kholia/HF-Pre-Amp/README.md

Reference: https://www.qsl.net/py2ohh/trx/buffer/buffer.html

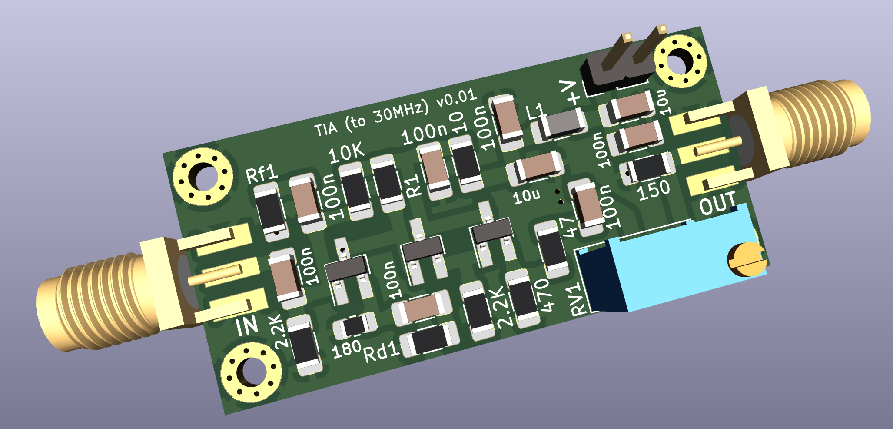
[picture p1: v5/Screenshot_2023-09-03_21-09-13.png]
Render


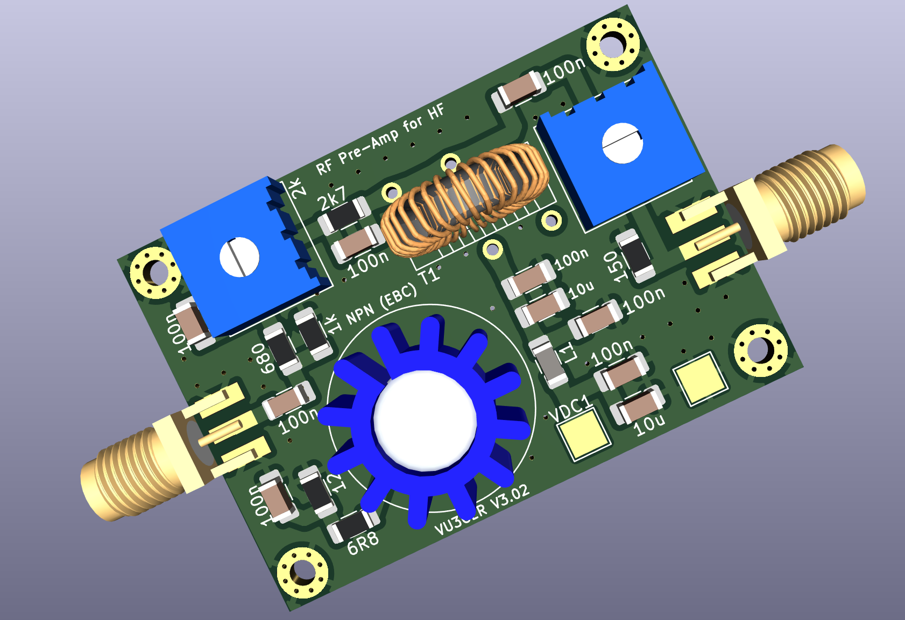
[picture p2: v3/Screenshot_2023-09-11_07-42-22.png]
Render 2


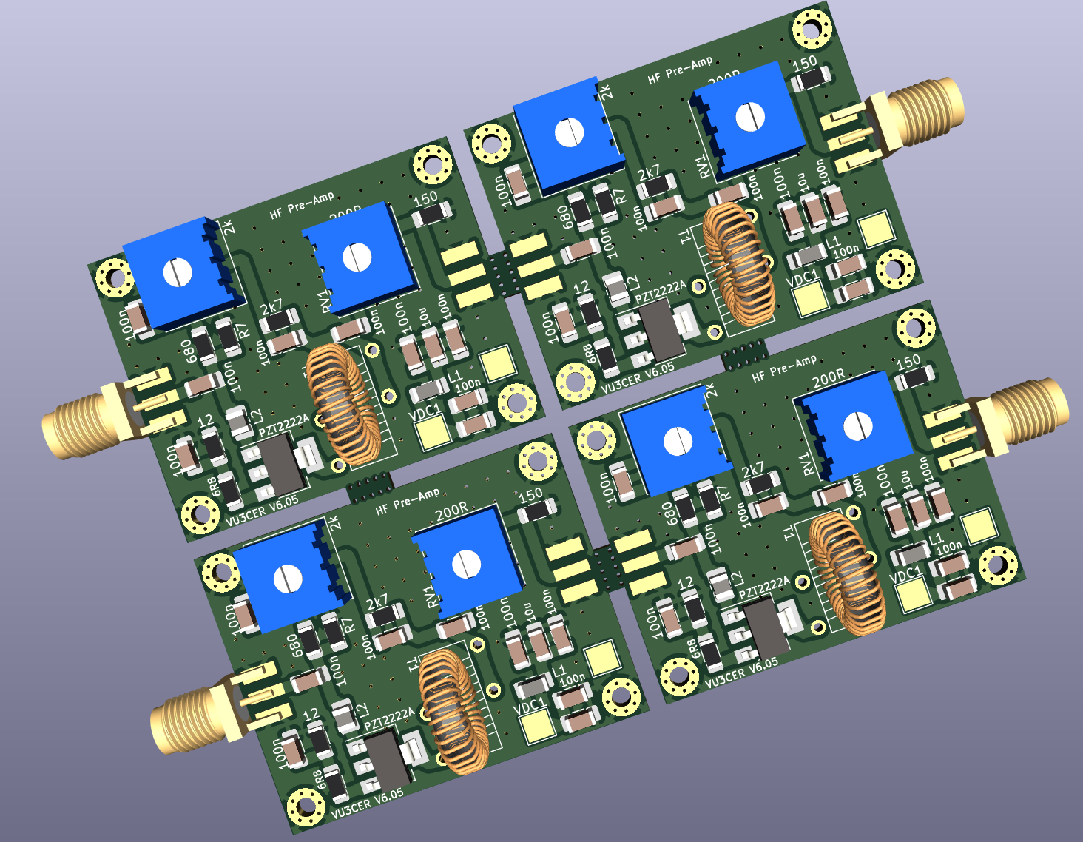
[picture p3: v6/Screenshot_2023-09-11_23-24-13.png]
Render 3
