kholia/HF-Pre-Amp/v7/README.md

https://remoteqth.com/wiki/index.php?page=RX+-+Preamp+module+2N5109

https://hamparts.shop/rx-small-preamp-with-2sc5551.html

http://www.mtmscientific.com/preamp.html

Set bias current to 60-65mA using the base drive resistor for NXP PZT2222A.
