kholia/HF-Pre-Amp/v7/info/15_2_850.jpg

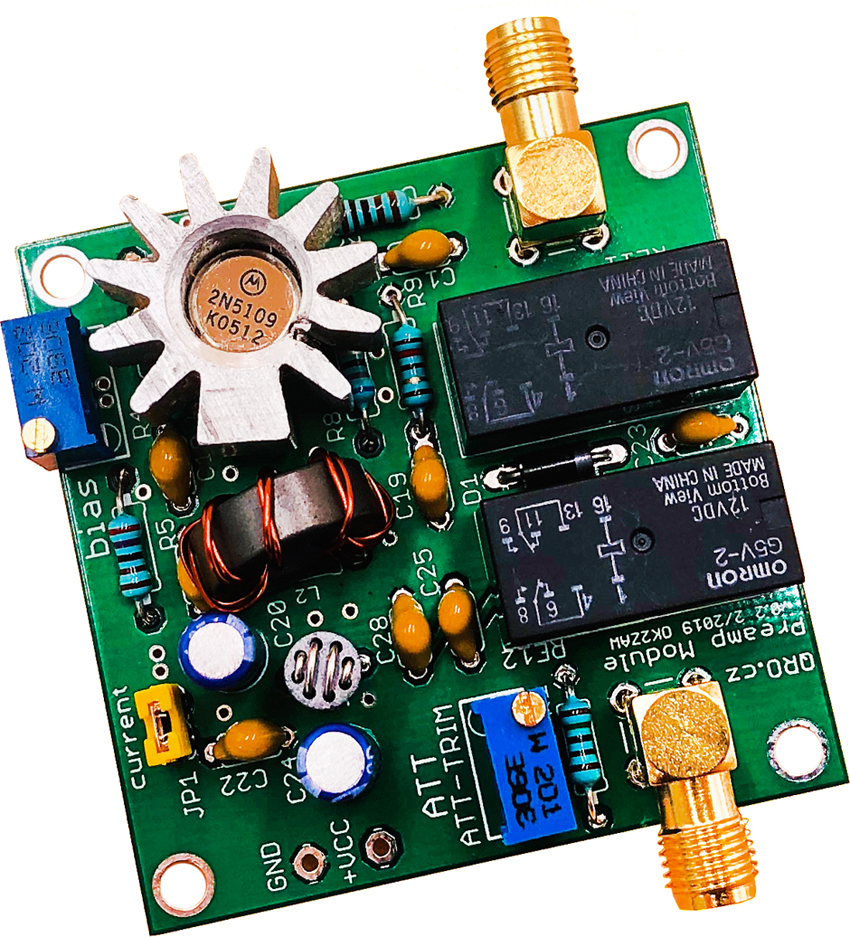
v7/info/15_2_850.jpg
