kholia/HF-Pre-Amp/v7/info/sch_v0.1.png

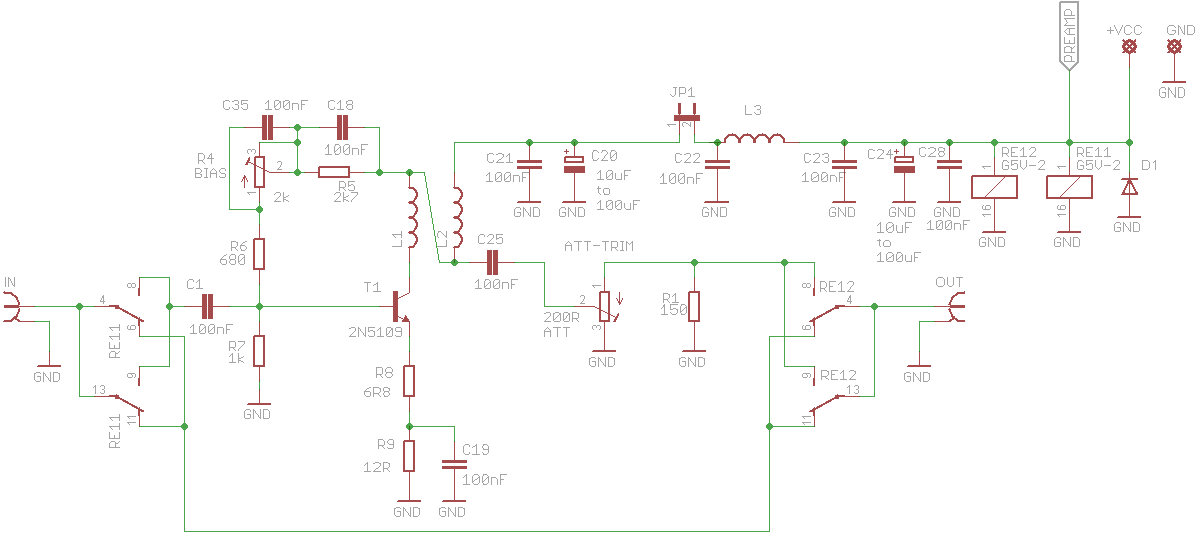
v7/info/sch_v0.1.png
