kholia/HF-Pre-Amp/v7/info/Screenshot_2023-09-11_07-22-50.png

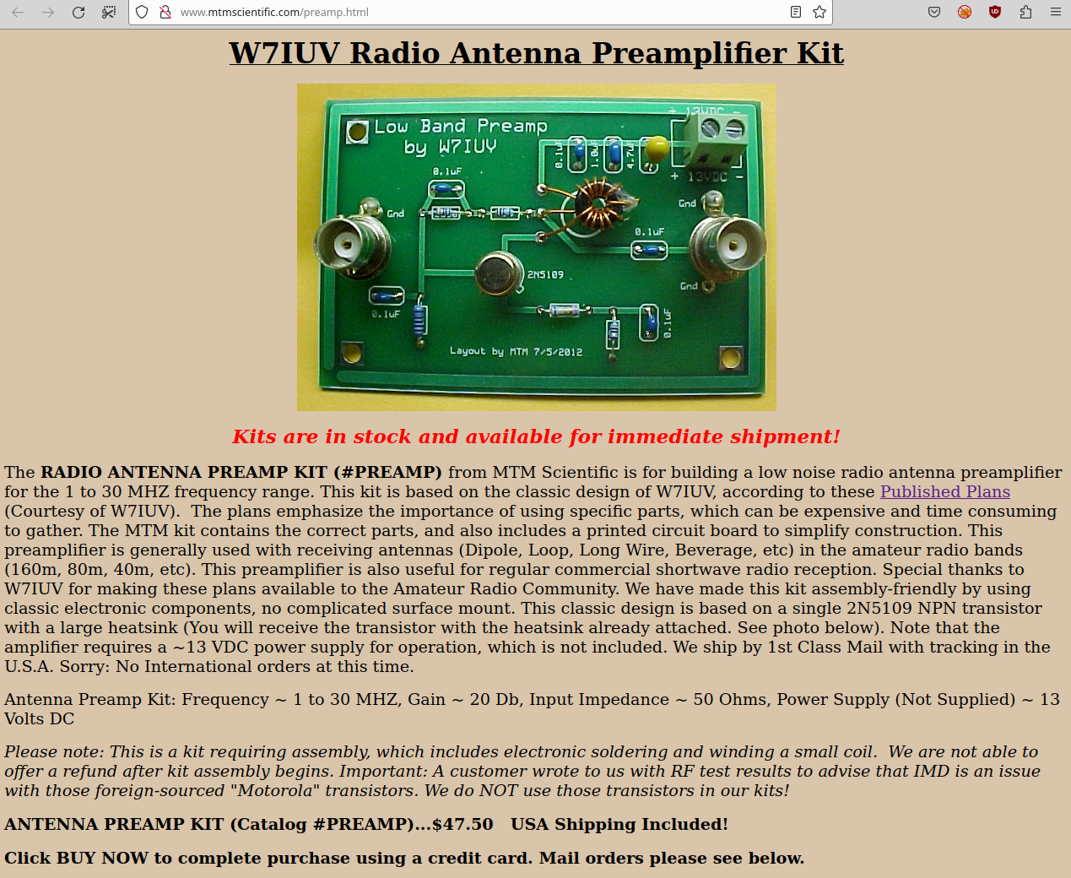
v7/info/Screenshot_2023-09-11_07-22-50.png
