kholia/HF-Pre-Amp/v7/Screenshot_2023-09-11_17-45-06.png

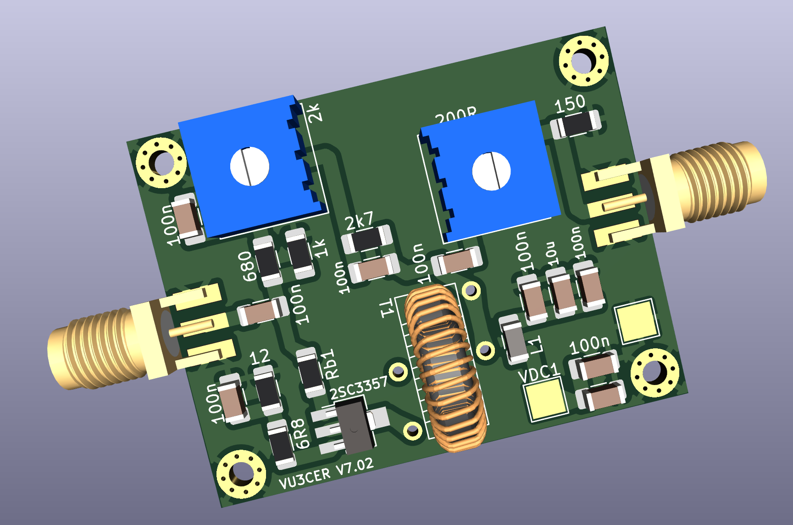
v7/Screenshot_2023-09-11_17-45-06.png
