kholia/HF-Pre-Amp/v7/models/User Library-3386P.STEP

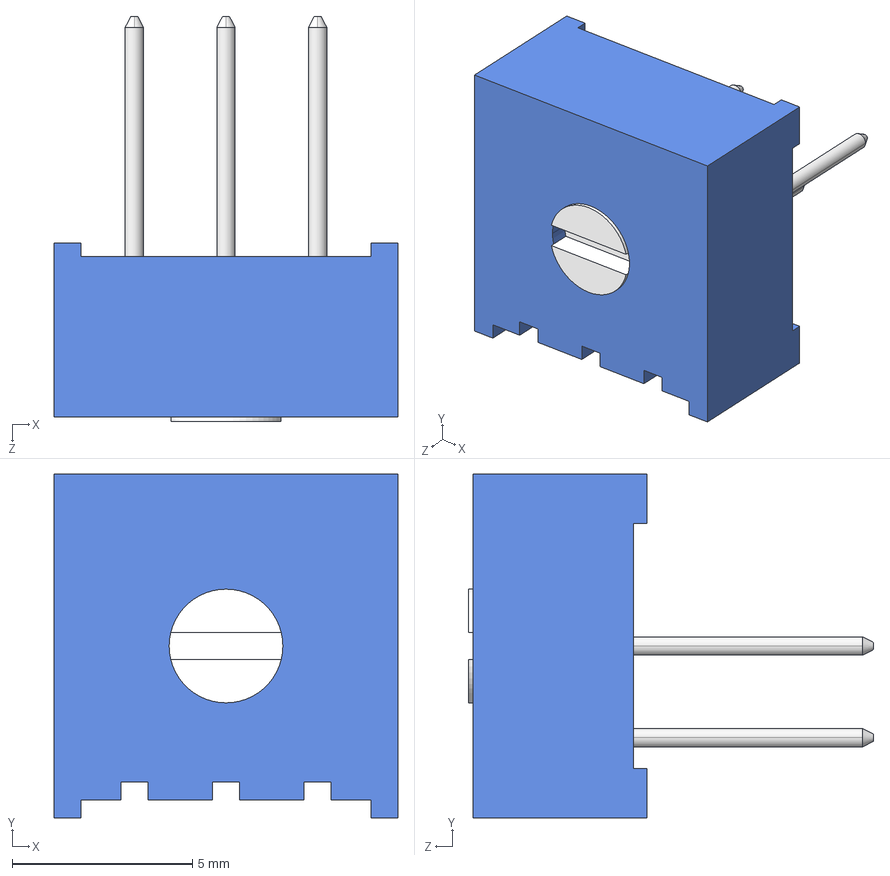
[picture p23: CAD file, 2023-09-12]
v7/models/User Library-3386P.STEP
9.53 x 9.53 x 11.2 mm
