kholia/HF-Pre-Amp/v7/models/User Library-Heatsink_TO-39.STEP

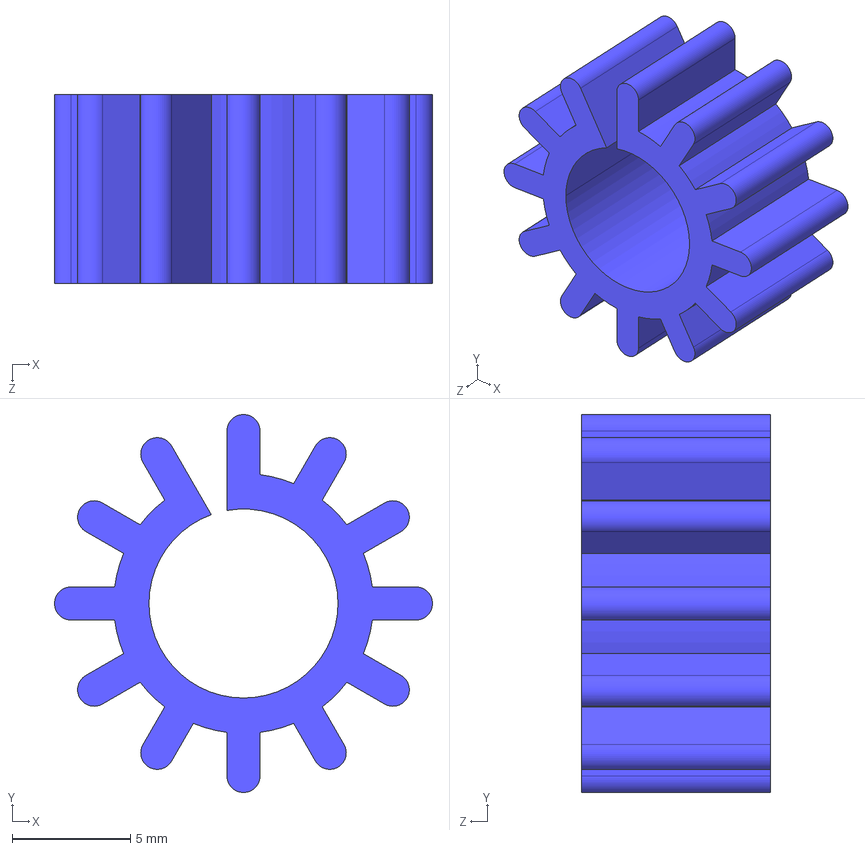
[picture p24: CAD file, 2023-09-12]
v7/models/User Library-Heatsink_TO-39.STEP
16.0 x 16.0 x 8.00 mm
