kholia/HF-Pre-Amp/v7/models/User Library-TO-39_2N2218.STEP

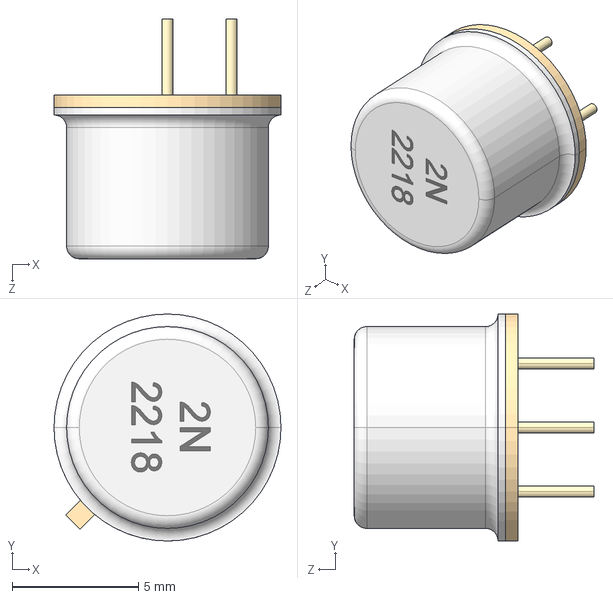
[picture p25: CAD file, 2023-09-12]
v7/models/User Library-TO-39_2N2218.STEP
9.00 x 9.00 x 9.50 mm
