kholia/HF-Pre-Amp/v7/models/User Library-TO-39_TO-205AD.STEP

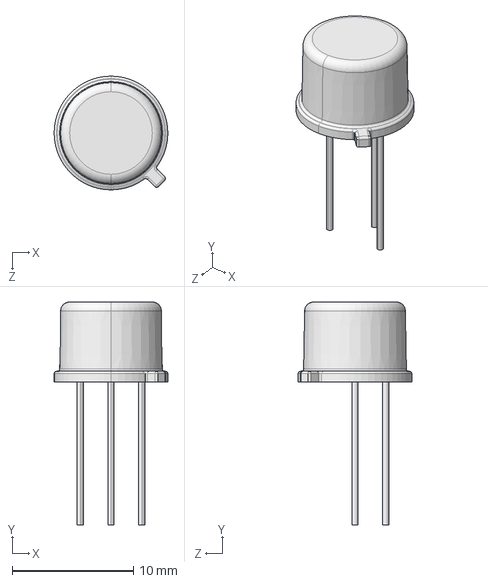
[picture p26: CAD file, 2023-09-12]
v7/models/User Library-TO-39_TO-205AD.STEP
9.40 x 18.4 x 9.40 mm
