kholia/HF-Pre-Amp/v7/models/CON-SMA-EDGE-S--3DModel-STEP-56544.STEP

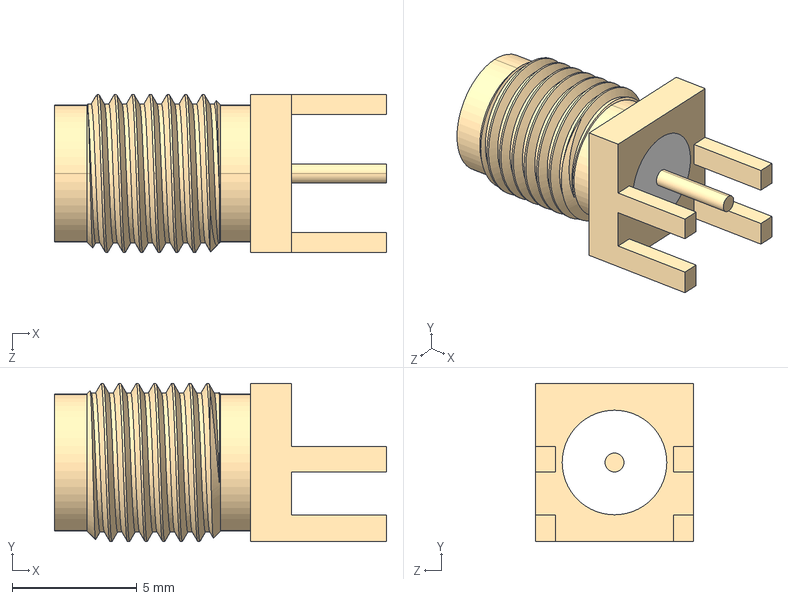
[picture p27: CAD file, 2023-09-12]
v7/models/CON-SMA-EDGE-S--3DModel-STEP-56544.STEP
13.3 x 6.35 x 6.35 mm
