kholia/HF-Pre-Amp/v7/info/v1.1.pdf

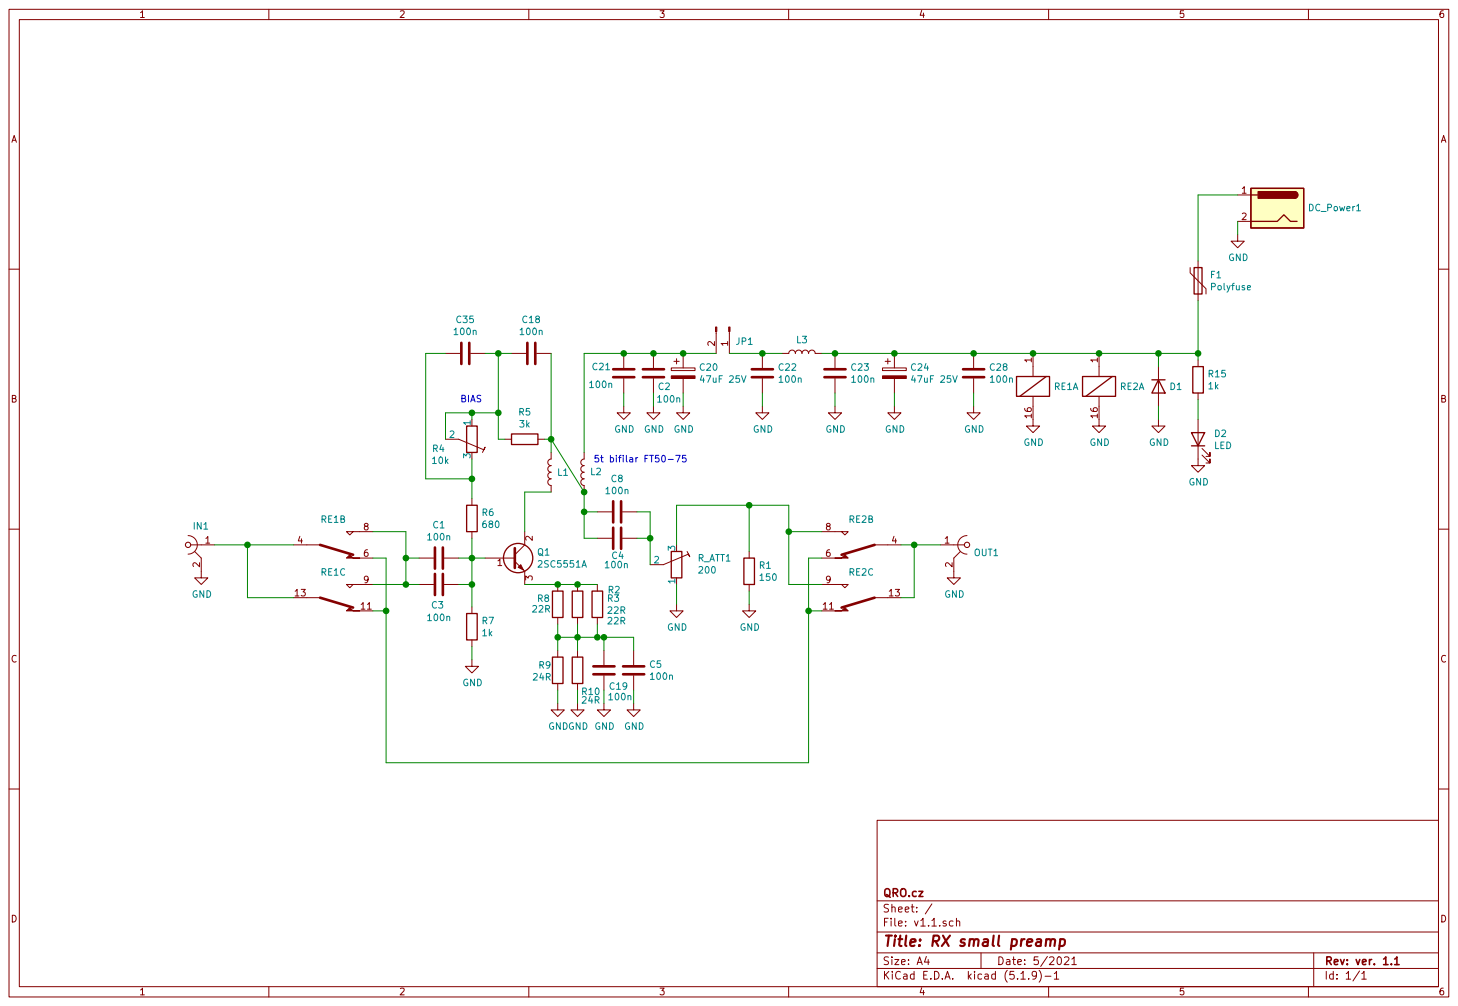
[picture p32: page 1]

File: v1.1.sch Sheet: / QRO.cz GND

Id: 1/1 Title: RX small preamp
