kholia/HF-Pre-Amp/v7/HF-Pre-Amp.pdf

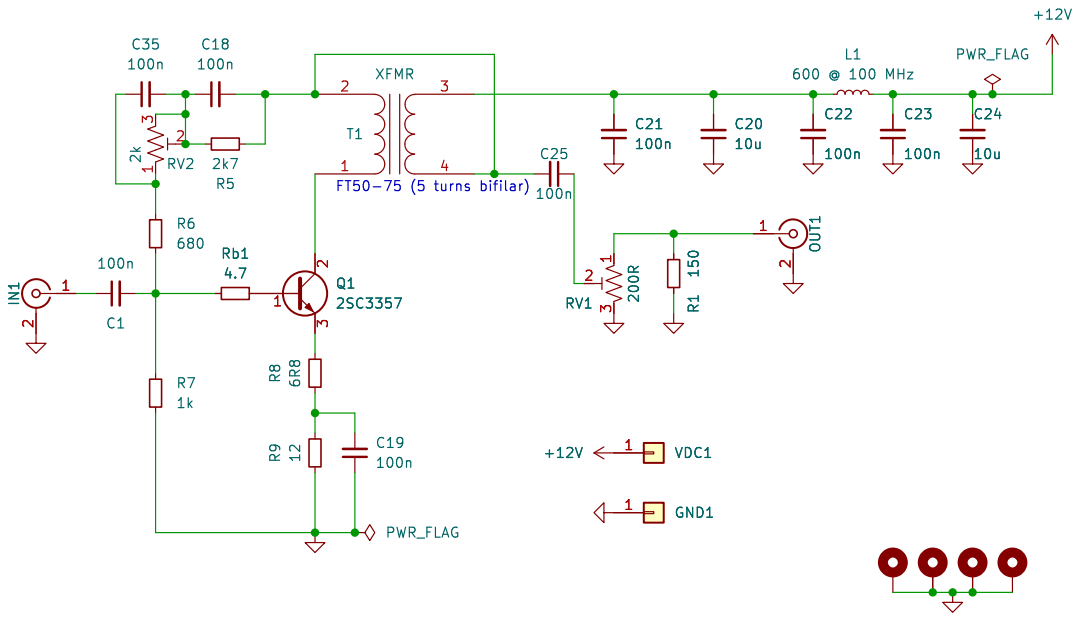
[picture p33: page 1]
