kholia/HF-Pre-Amp/v2/info/hbr-cw-schematic.pdf

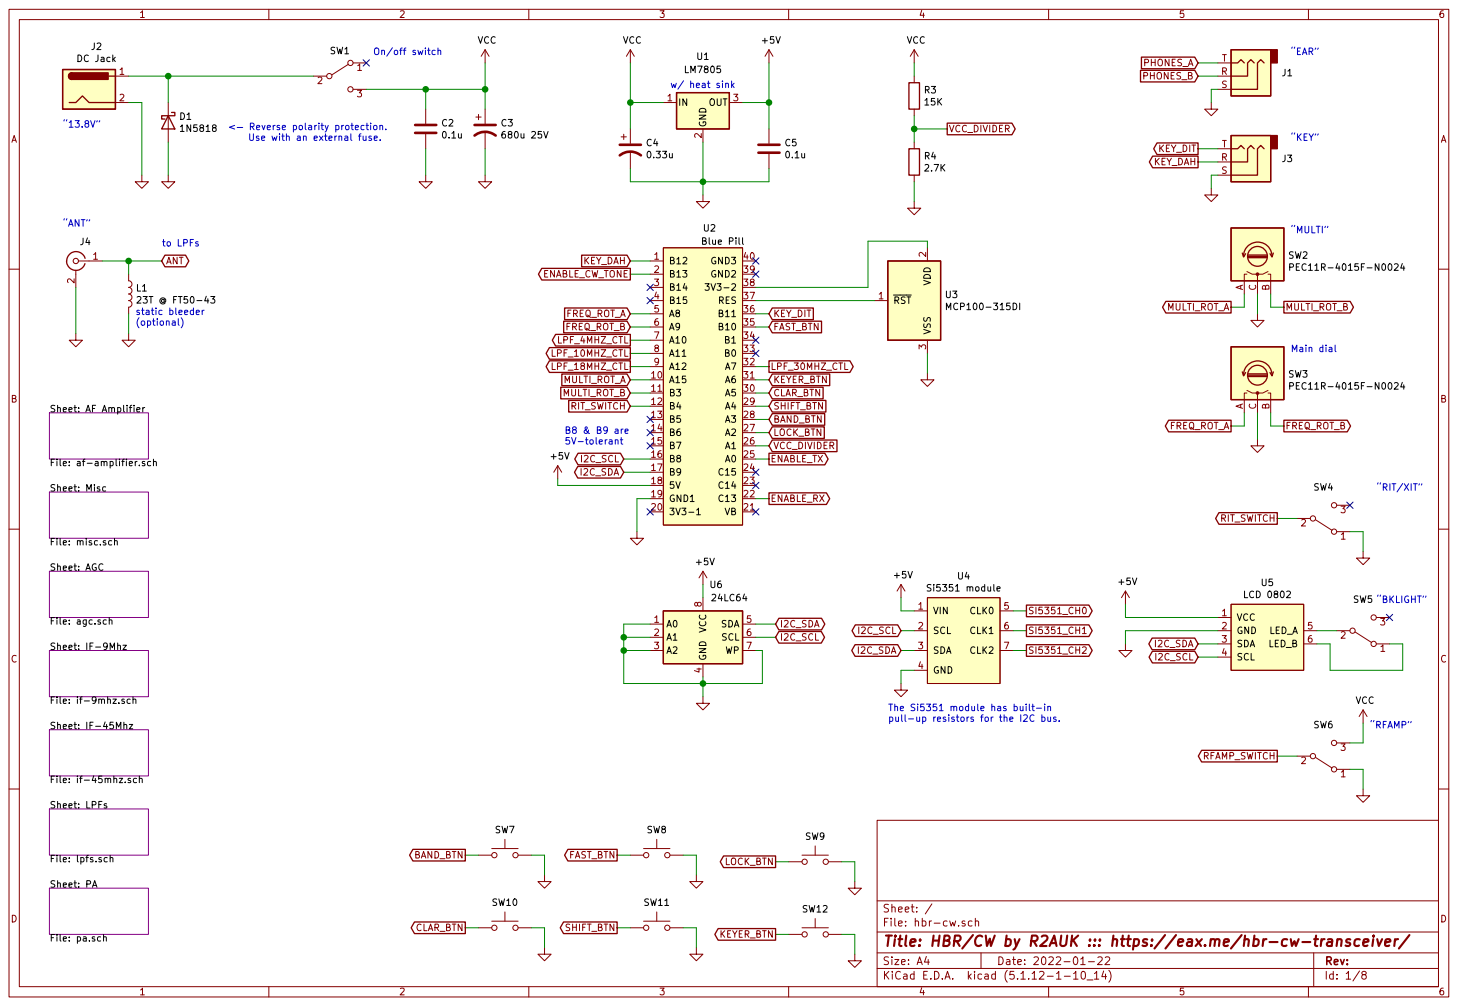
[picture p34: page 1]

File: af-amplifier.sch Sheet: Misc File: misc.sch Sheet: AGC

File: agc.sch Sheet: IF-9Mhz File: if-9mhz.sch Sheet: IF-45Mhz File: if-45mhz.sch Sheet: LPFs File: lpfs.sch Sheet: PA

4 SDA 5 SCL 6 WP 7 VCC

The Si5351 module has built-in

Id: 1/8 Title: HBR/CW by R2AUK ::: https://eax.me/hbr-cw-transceiver/ File: hbr-cw.sch Sheet: /

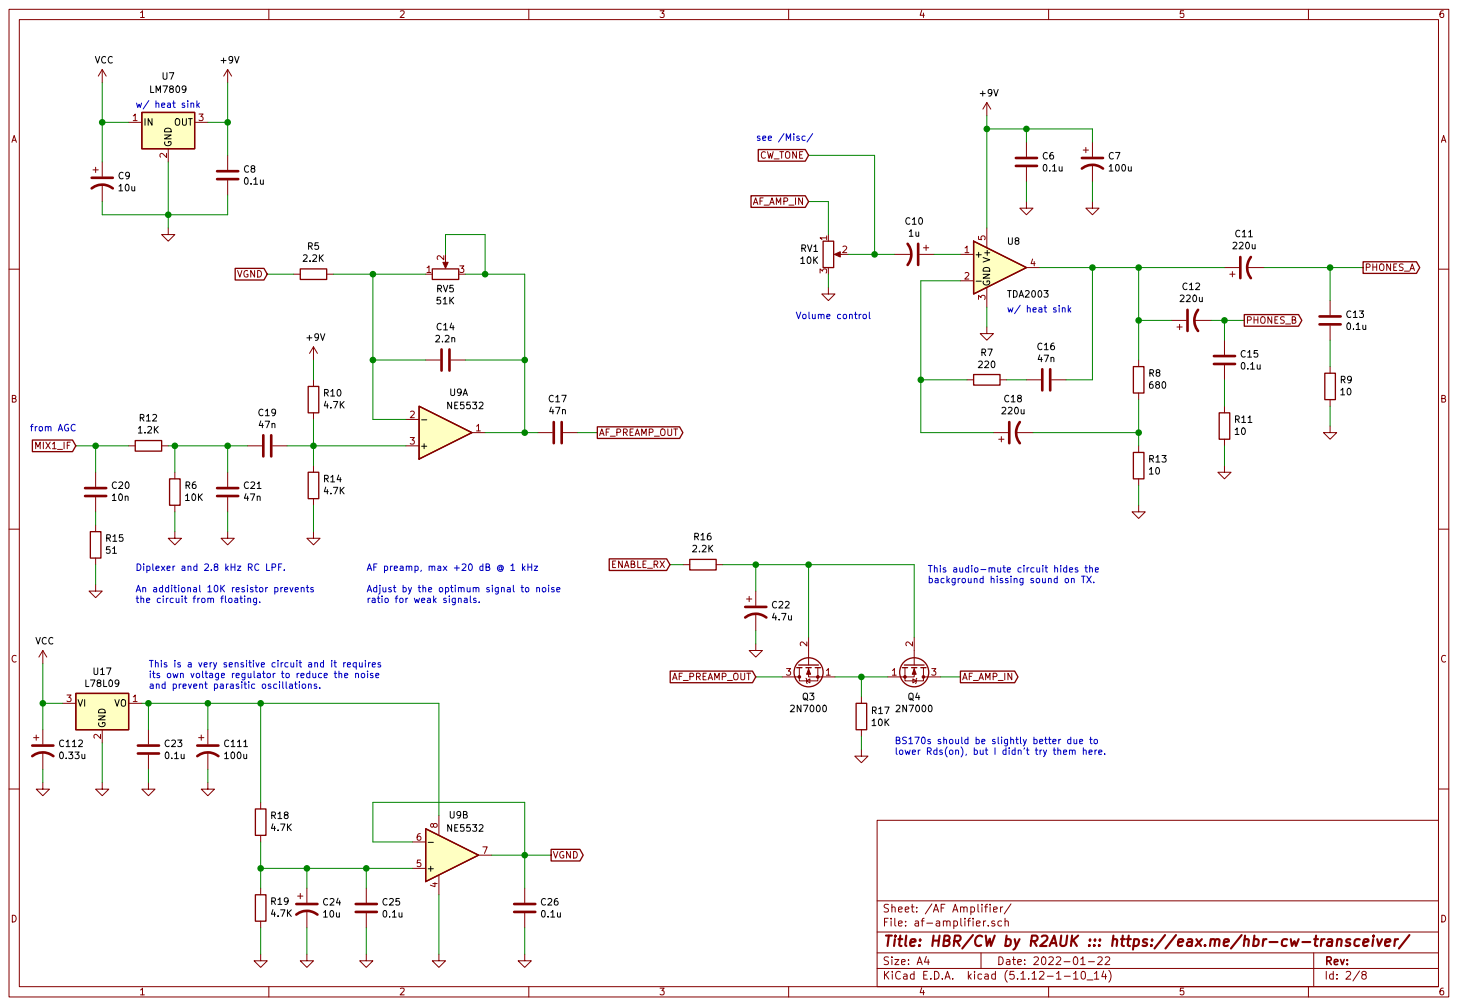
[picture p35: page 2]

Diplexer and 2.8 kHz RC LPF.

AF preamp, max +20 dB @ 1 kHz

background hissing sound on TX.

An additional 10K resistor prevents
the circuit from floating.

Adjust by the optimum signal to noise
ratio for weak signals.

This is a very sensitive circuit and it requires
its own voltage regulator to reduce the noise

BS170s should be slightly better due to
lower Rds(on), but I didnt try them here.

Sheet: /AF Amplifier/
File: af-amplifier.sch
Id: 2/8 Title: HBR/CW by R2AUK ::: https://eax.me/hbr-cw-transceiver/

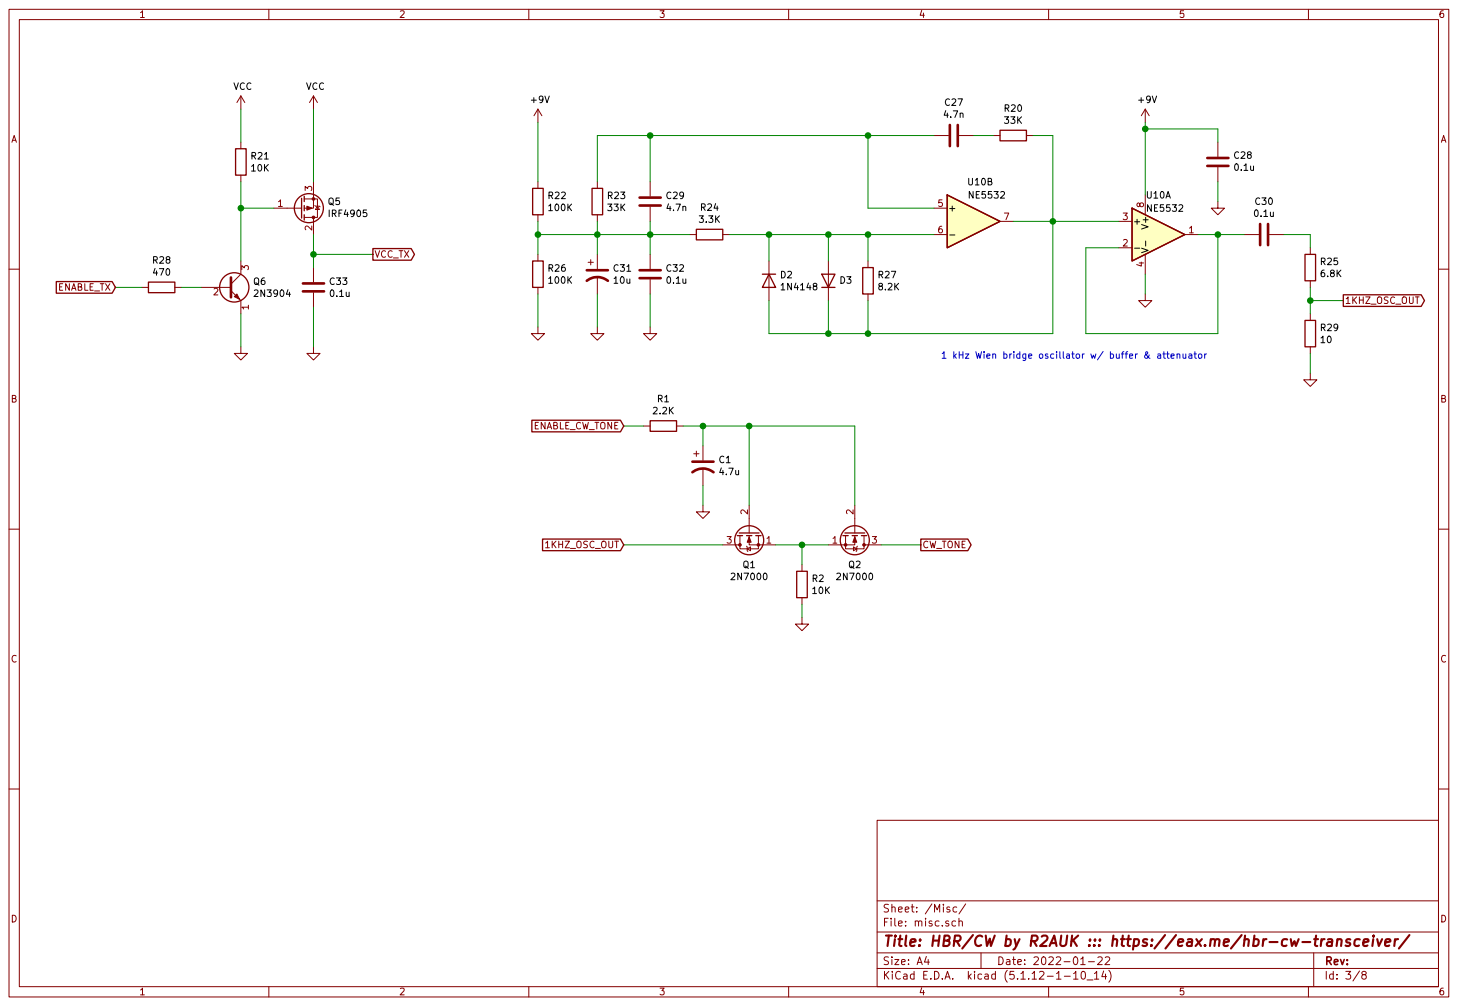
[picture p36: page 3]

1 kHz Wien bridge oscillator w/ buffer & attenuator

Id: 3/8 Title: HBR/CW by R2AUK ::: https://eax.me/hbr-cw-transceiver/ File: misc.sch Sheet: /Misc/

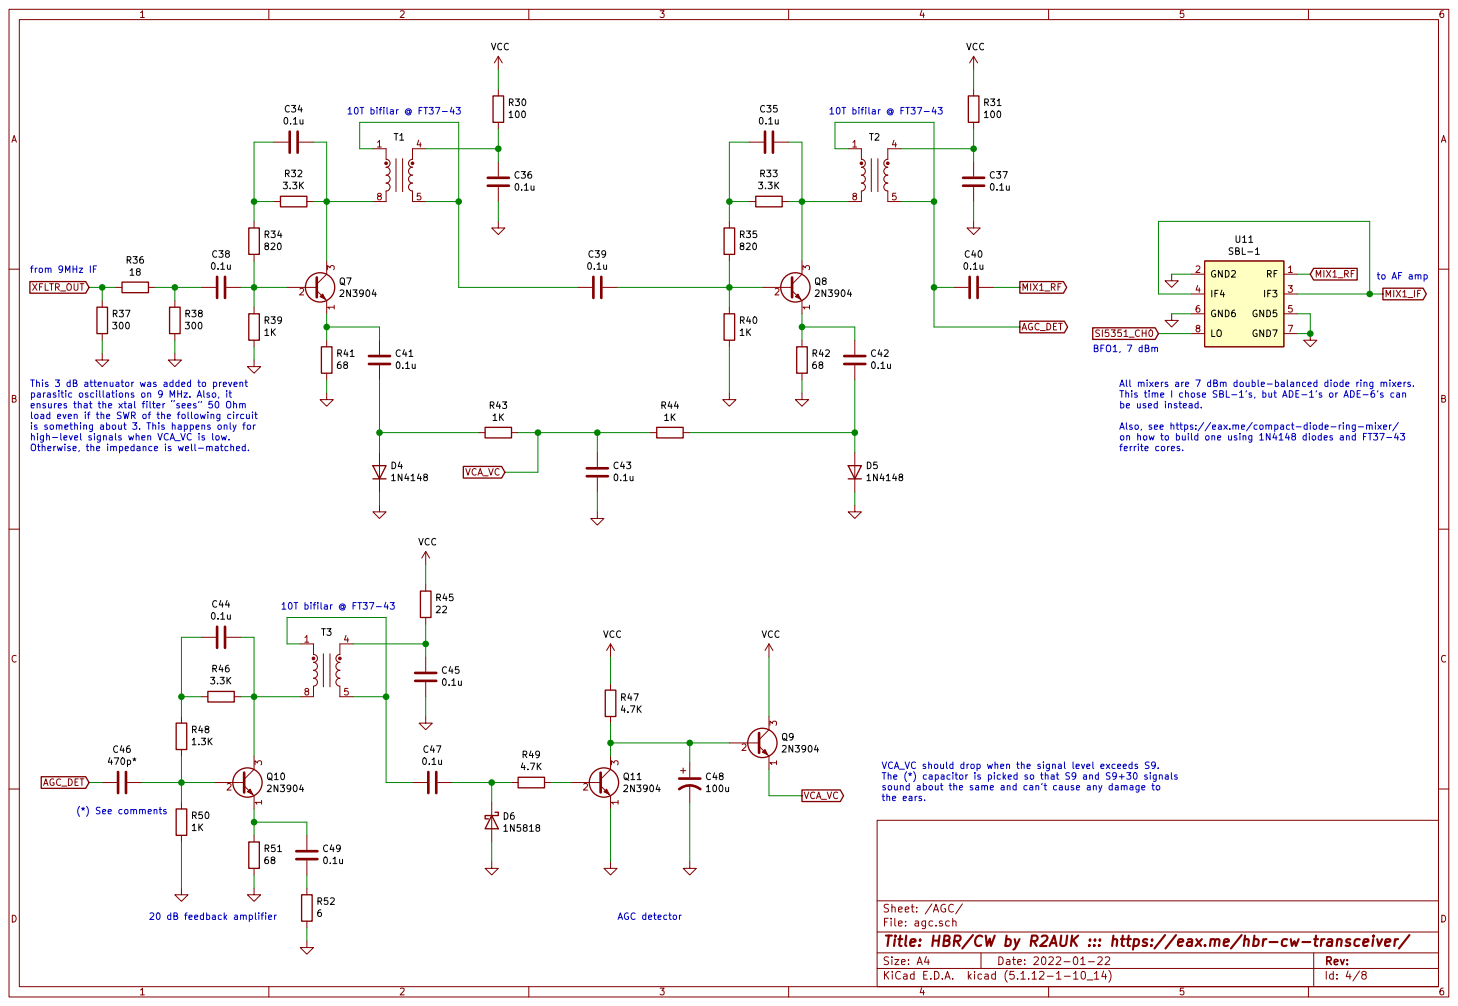
[picture p37: page 4]

This 3 dB attenuator was added to prevent
parasitic oscillations on 9 MHz. Also, it ensures that the xtal filter sees 50 Ohm
load even if the SWR of the following circuit
is something about 3. This happens only for
high-level signals when VCA_VC is low.

be used instead. Also, see https://eax.me/compact-diode-ring-mixer/

on how to build one using 1N4148 diodes and FT37-43
ferrite cores.

VCA_VC should drop when the signal level exceeds S9.
The (*) capacitor is picked so that S9 and S9+30 signals
sound about the same and cant cause any damage to

the ears. AGC detector

File: agc.sch Sheet: /AGC/
Id: 4/8 Title: HBR/CW by R2AUK ::: https://eax.me/hbr-cw-transceiver/

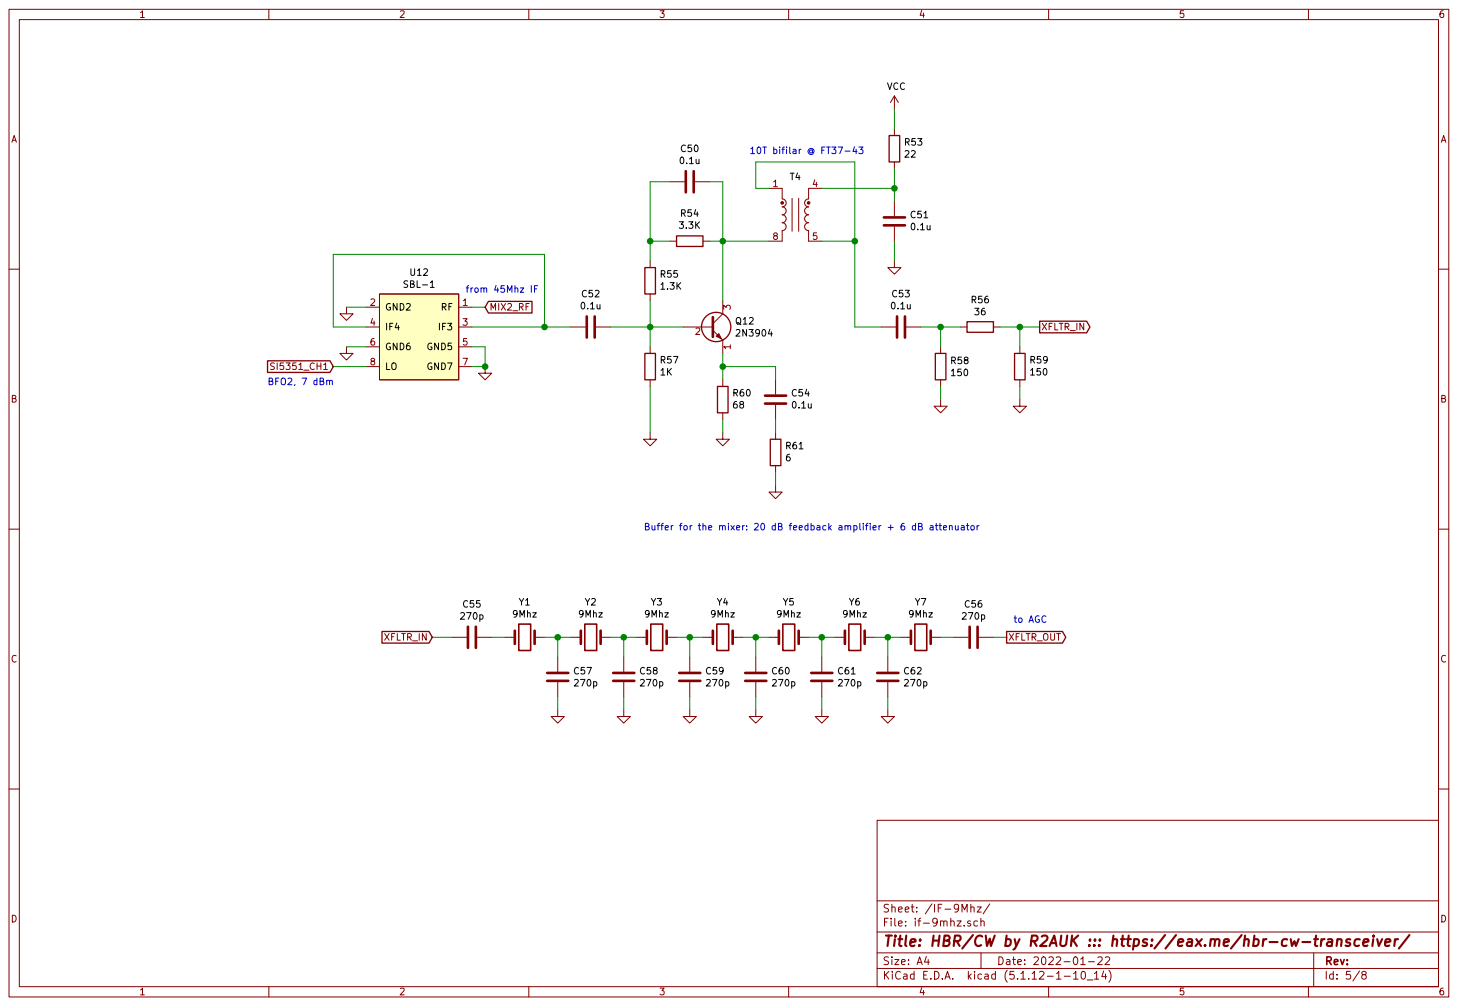
[picture p38: page 5]

Buffer for the mixer: 20 dB feedback amplifier + 6 dB attenuator

Id: 5/8 Title: HBR/CW by R2AUK ::: https://eax.me/hbr-cw-transceiver/ File: if-9mhz.sch Sheet: /IF-9Mhz/

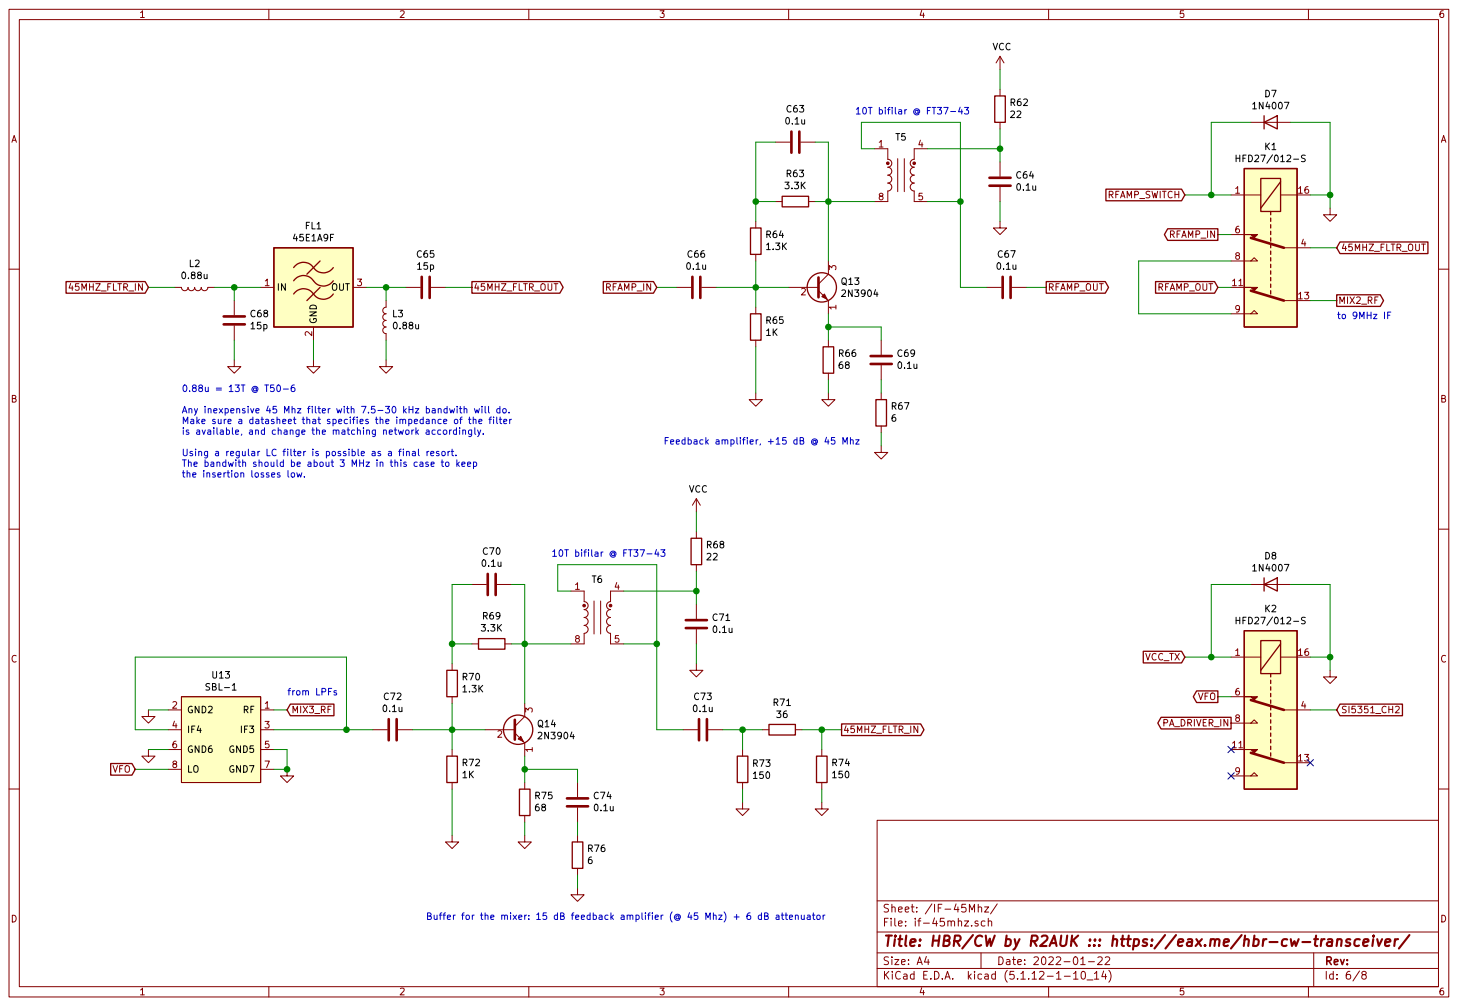
[picture p39: page 6]

0.88u = 13T @ T50-6 Any inexpensive 45 Mhz filter with 7.5-30 kHz bandwith will do.

Make sure a datasheet that specifies the impedance of the filter
is available, and change the matching network accordingly.
Using a regular LC filter is possible as a final resort.
The bandwith should be about 3 MHz in this case to keep

Id: 6/8 Title: HBR/CW by R2AUK ::: https://eax.me/hbr-cw-transceiver/ File: if-45mhz.sch Sheet: /IF-45Mhz/ R75

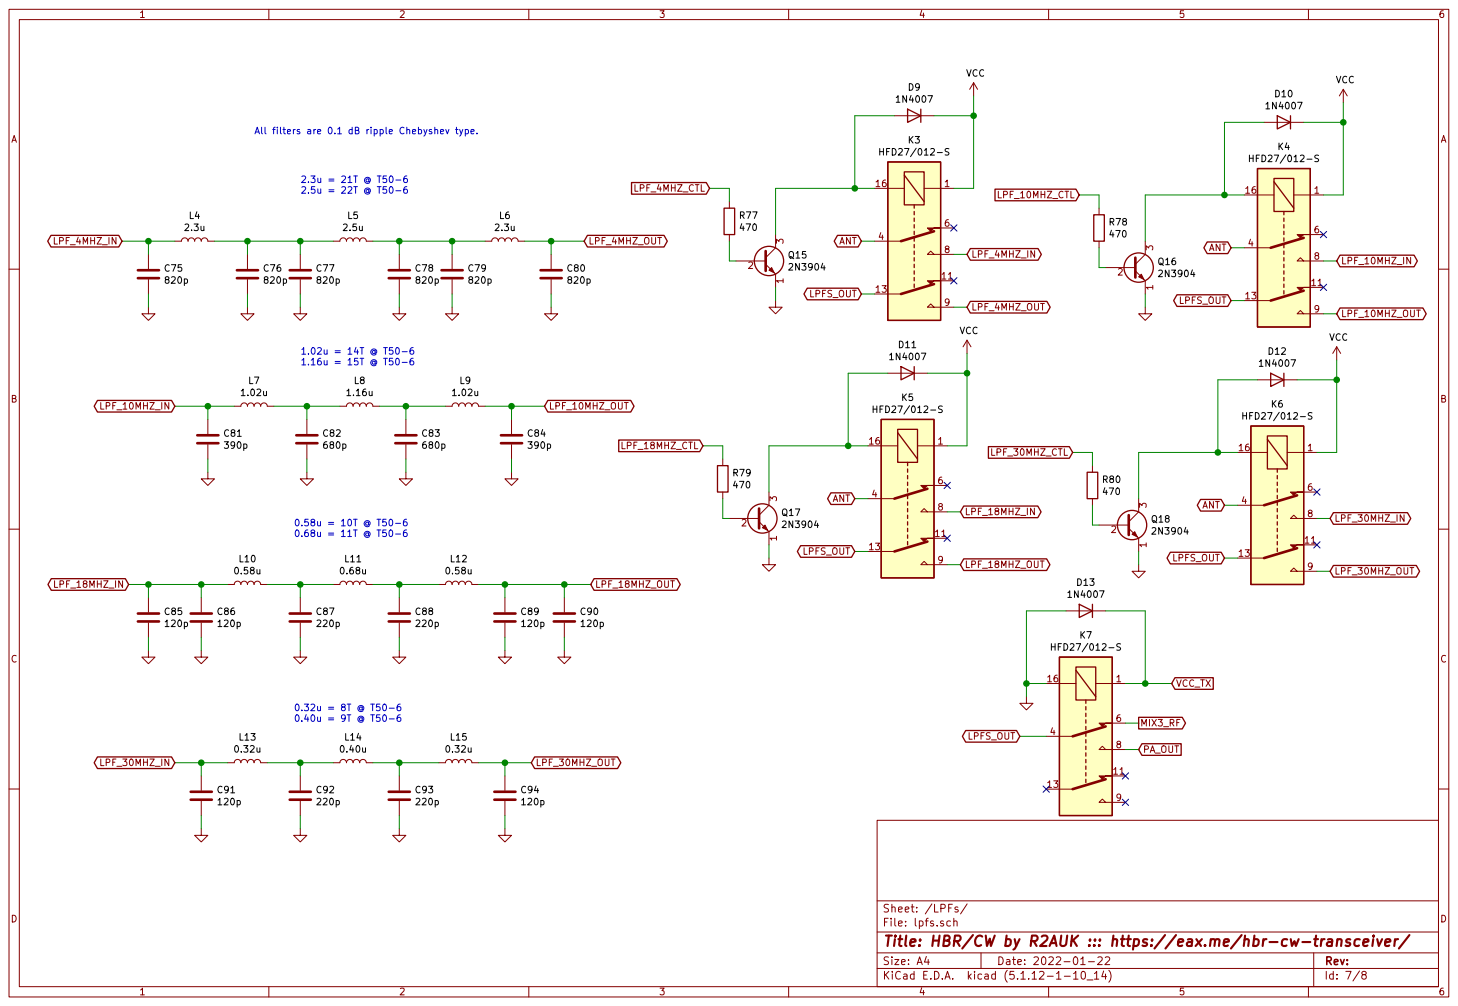
[picture p40: page 7]

All filters are 0.1 dB ripple Chebyshev type.

File: lpfs.sch Sheet: /LPFs/
Id: 7/8 Title: HBR/CW by R2AUK ::: https://eax.me/hbr-cw-transceiver/

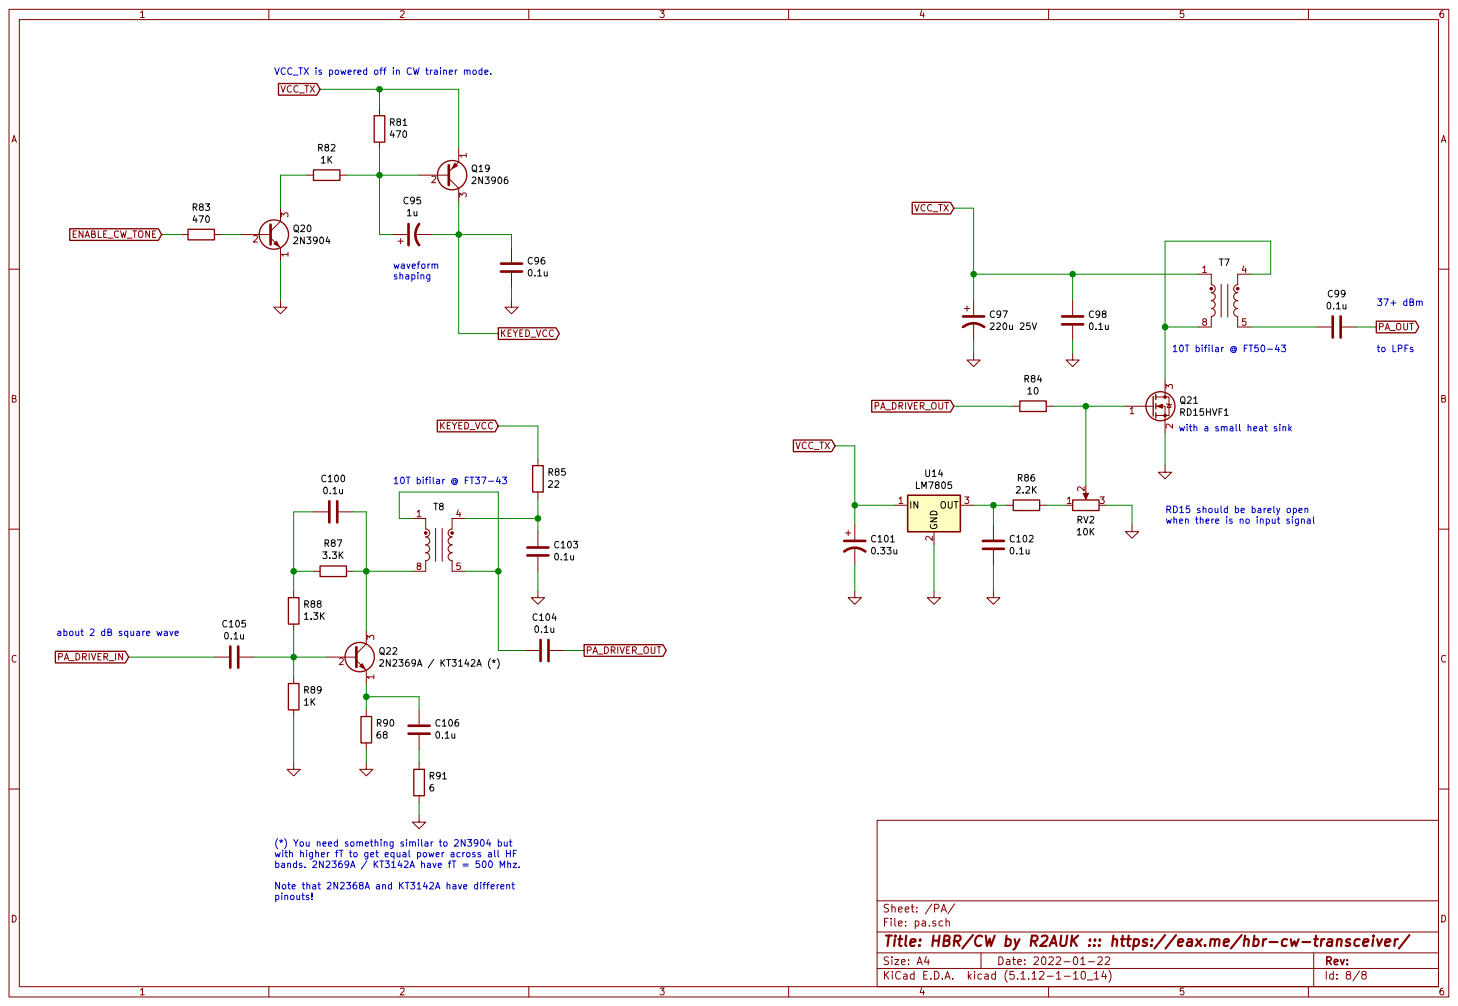
[picture p41: page 8]

VCC_TX is powered off in CW trainer mode.
VCC_TX

PA_OUT with a small heat sink waveform shaping

RD15 should be barely open

about 2 dB square wave

File: pa.sch Sheet: /PA/ 1

(*) You need something similar to 2N3904 but
with higher fT to get equal power across all HF
bands. 2N2369A / KT3142A have fT = 500 Mhz. Note that 2N2368A and KT3142A have different pinouts!

Id: 8/8 Title: HBR/CW by R2AUK ::: https://eax.me/hbr-cw-transceiver/
