kholia/HF-Pre-Amp/v2/info/ssb-transceiver-schematic.pdf

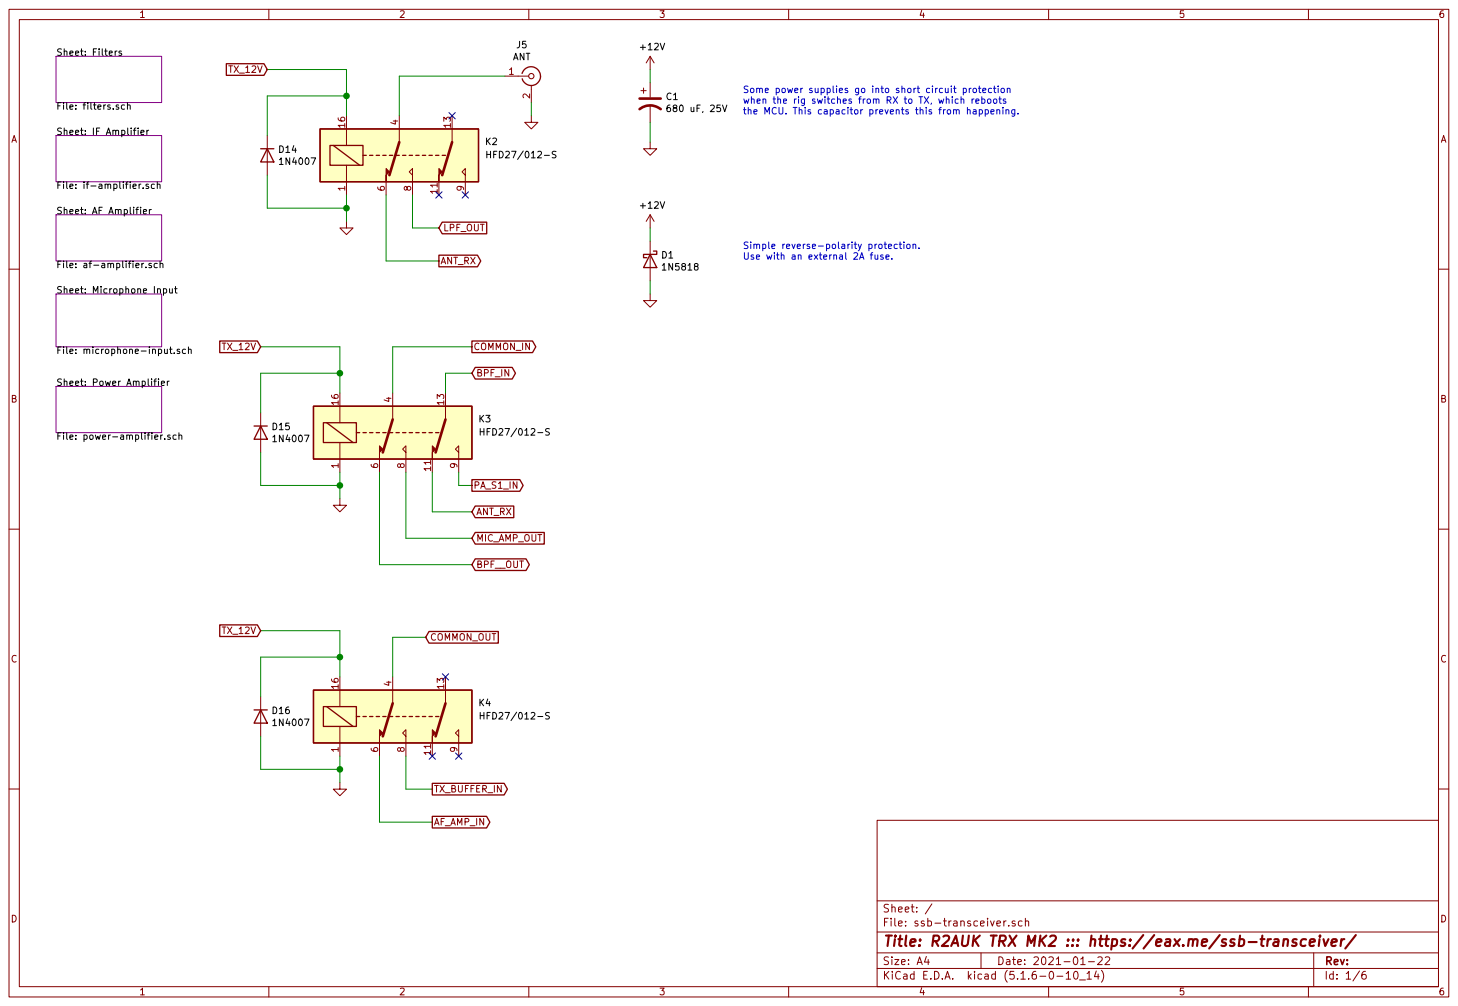
[picture p42: page 1]

Sheet: Filters File: filters.sch Sheet: IF Amplifier

Some power supplies go into short circuit protection
when the rig switches from RX to TX, which reboots
the MCU. This capacitor prevents this from happening.

File: if-amplifier.sch

Simple reverse-polarity protection. Use with an external 2A fuse.

File: af-amplifier.sch

File: power-amplifier.sch

Id: 1/6 Title: R2AUK TRX MK2 ::: https://eax.me/ssb-transceiver/ File: ssb-transceiver.sch Sheet: /

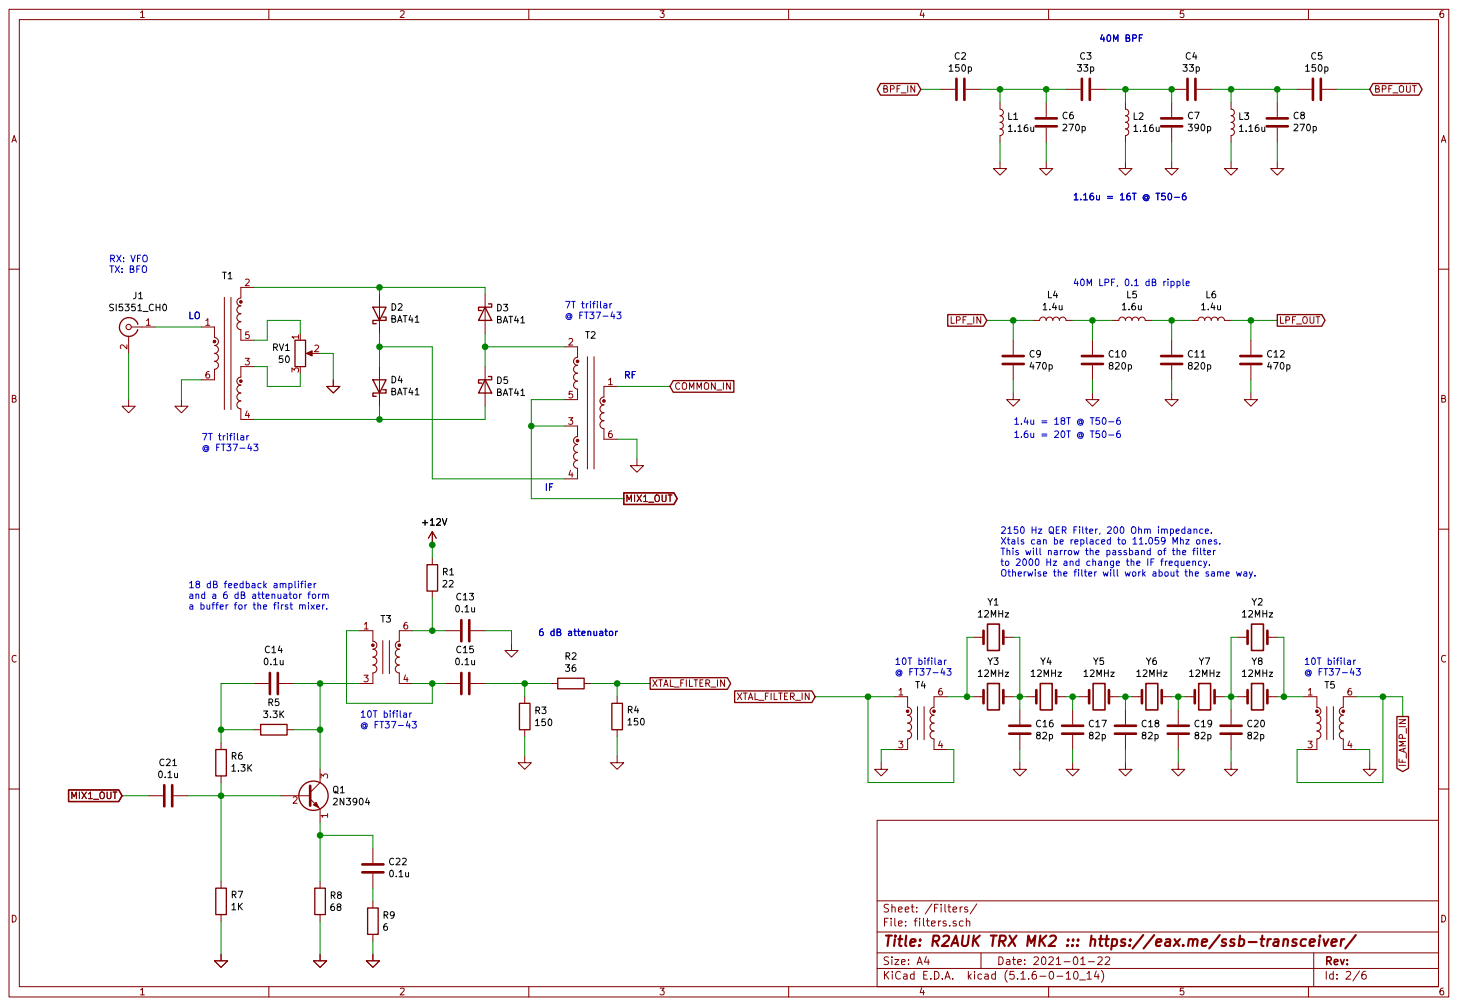
[picture p43: page 2]

Otherwise the filter will work about the same way. RF

2150 Hz QER Filter, 200 Ohm impedance.
Xtals can be replaced to 11.059 Mhz ones.
This will narrow the passband of the filter
to 2000 Hz and change the IF frequency.

18 dB feedback amplifier and a 6 dB attenuator form

Id: 2/6 Title: R2AUK TRX MK2 ::: https://eax.me/ssb-transceiver/ File: filters.sch Sheet: /Filters/

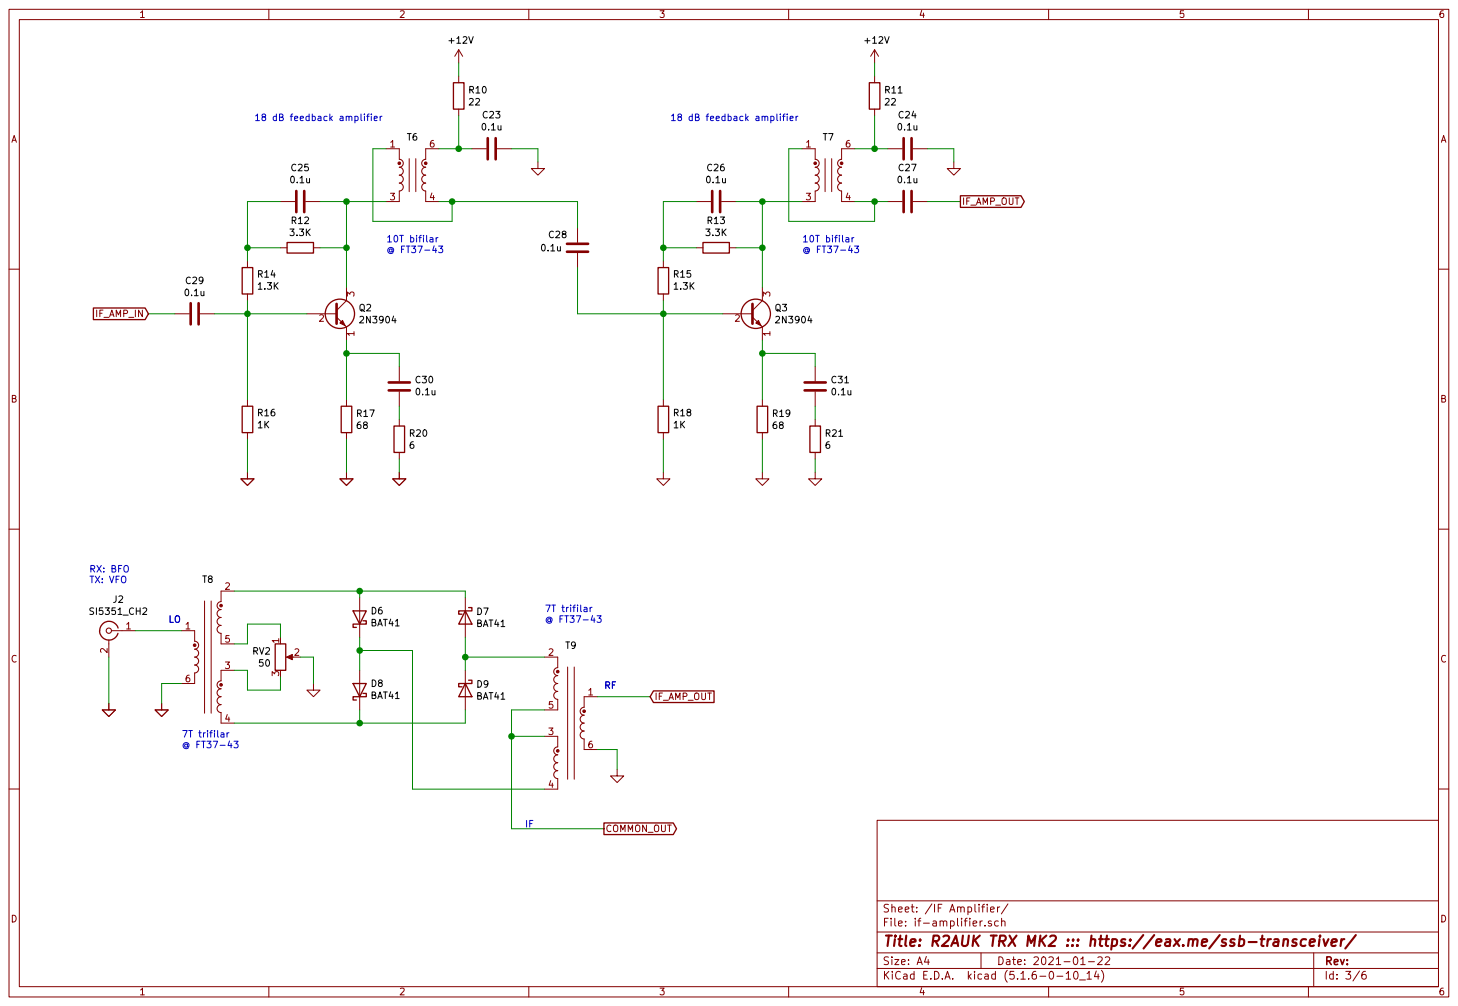
[picture p44: page 3]

Sheet: /IF Amplifier/
File: if-amplifier.sch
Id: 3/6 Title: R2AUK TRX MK2 ::: https://eax.me/ssb-transceiver/

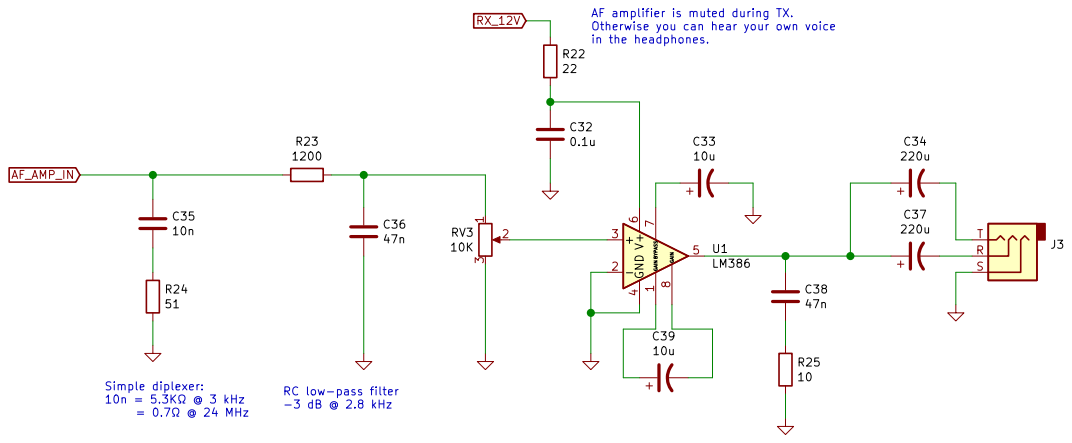
[picture p45: page 4]

RX_12V RC low-pass filter
10u GAIN 1

Otherwise you can hear your own voice
in the headphones.

-3 dB @ 2.8 kHz Simple diplexer: 10n = 5.3K @ 3 kHz

Sheet: /AF Amplifier/
File: af-amplifier.sch
Id: 4/6 Title: R2AUK TRX MK2 ::: https://eax.me/ssb-transceiver/

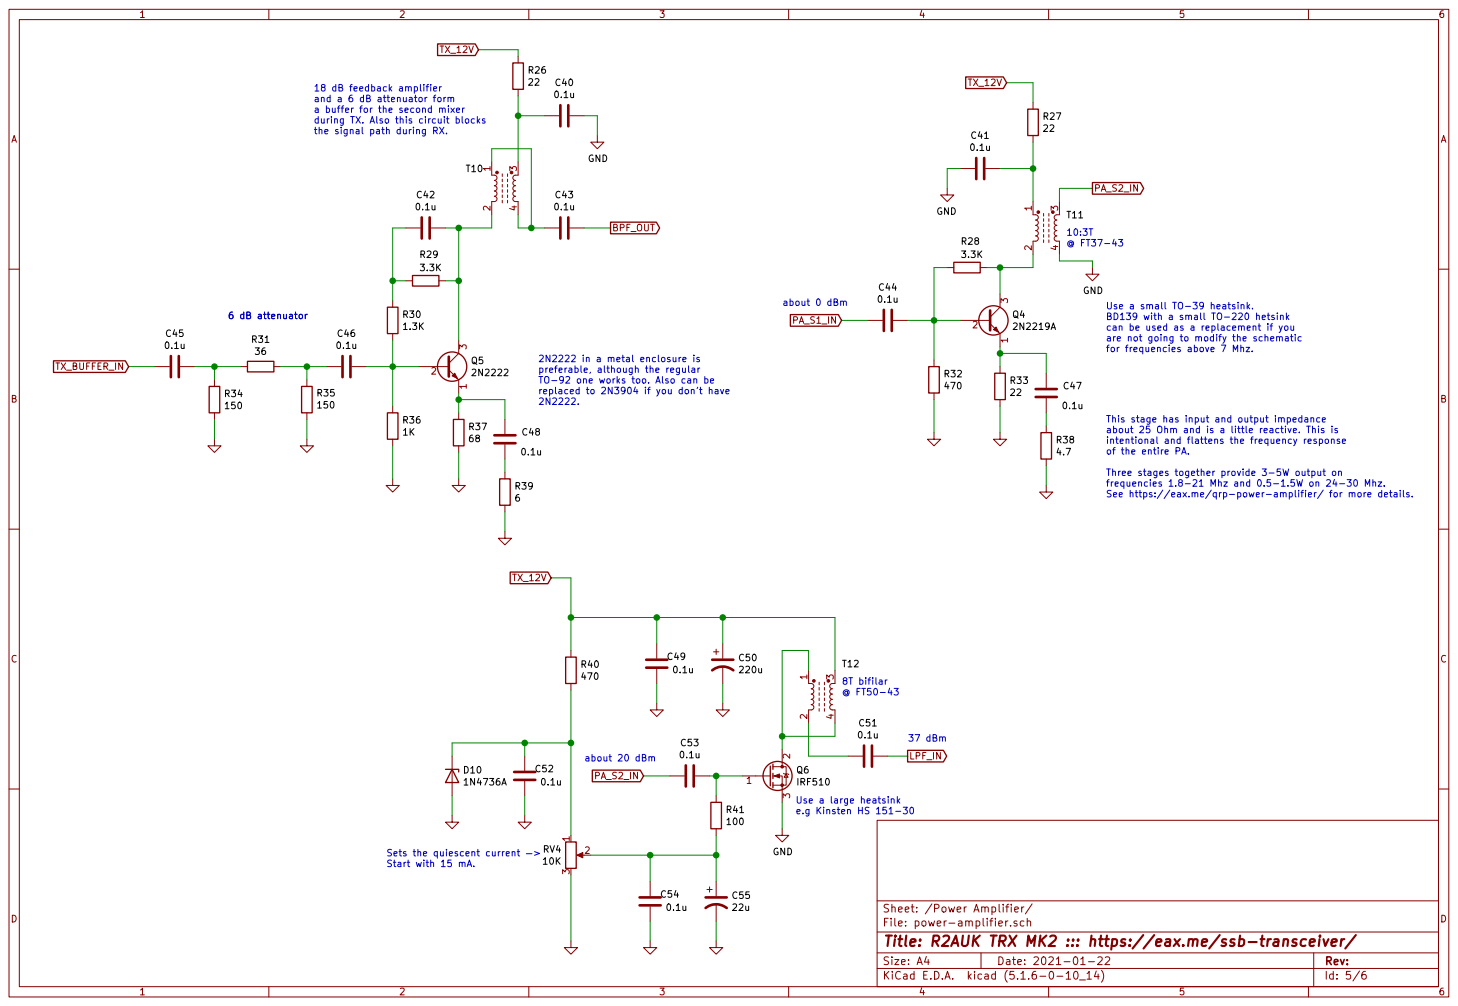
[picture p46: page 5]

18 dB feedback amplifier and a 6 dB attenuator form

a buffer for the second mixer during TX. Also this circuit blocks

the signal path during RX.

10:3T @ FT37-43Use a small TO-39 heatsink. BD139 with a small TO-220 hetsink

can be used as a replacement if you
are not going to modify the schematic
for frequencies above 7 Mhz.

2N2222 in a metal enclosure is preferable, although the regular TO-92 one works too. Also can be

replaced to 2N3904 if you dont have

This stage has input and output impedance
about 25 Ohm and is a little reactive. This is
intentional and flattens the frequency response
of the entire PA. Three stages together provide 3-5W output on

frequencies 1.8-21 Mhz and 0.5-1.5W on 24-30 Mhz.
See https://eax.me/qrp-power-amplifier/ for more details.

Sets the quiescent current > Start with 15 mA.

Sheet: /Power Amplifier/
File: power-amplifier.sch
Id: 5/6 Title: R2AUK TRX MK2 ::: https://eax.me/ssb-transceiver/

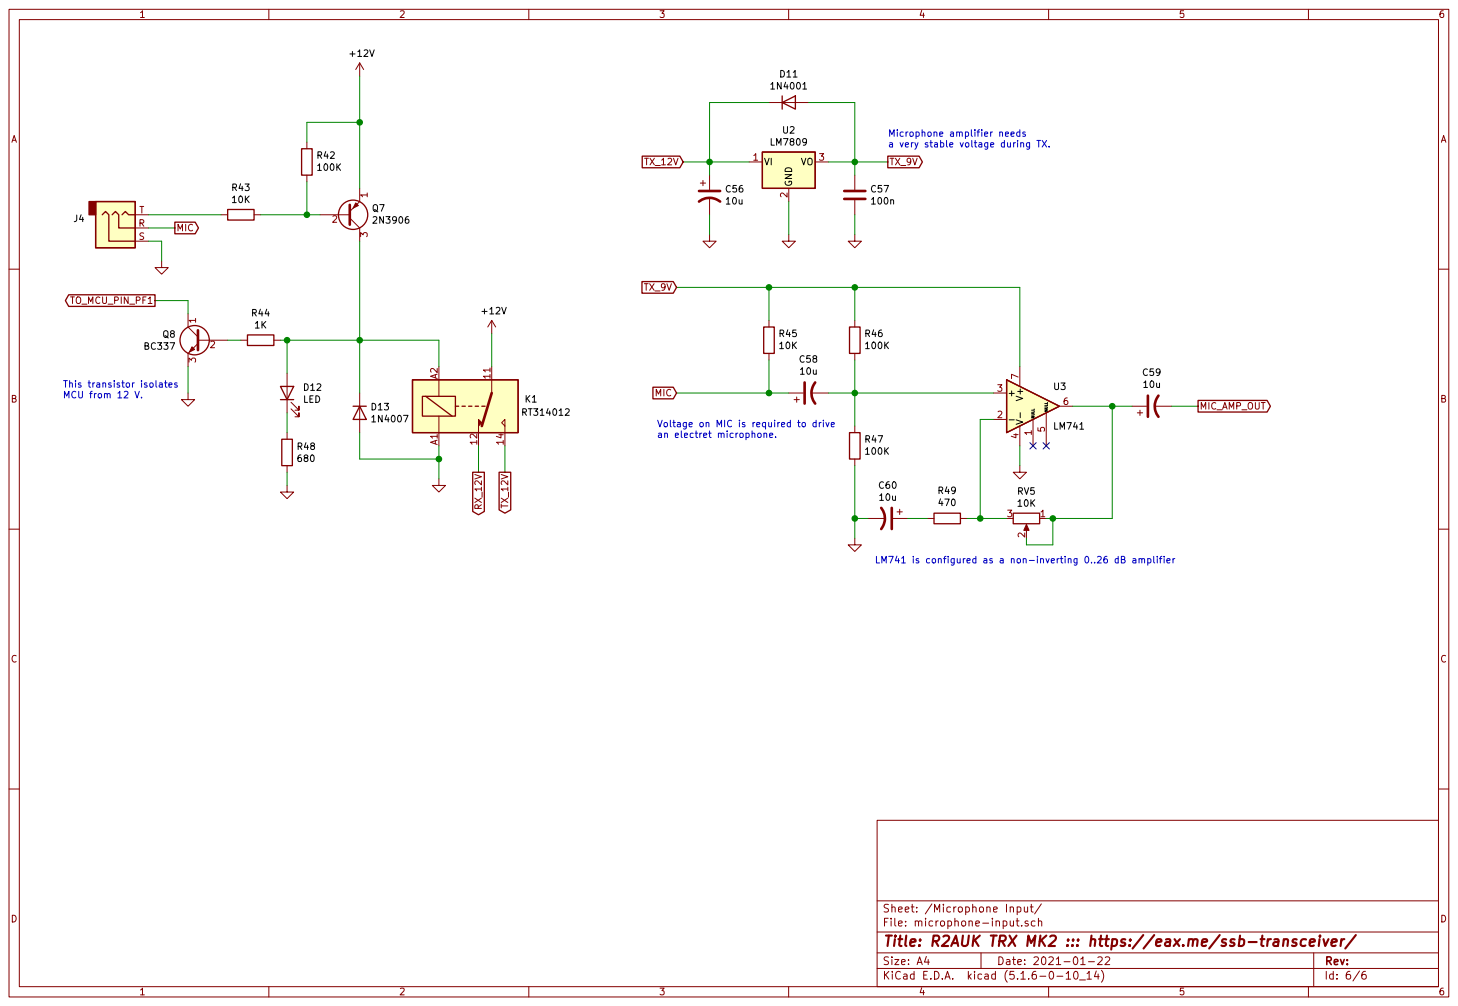
[picture p47: page 6]

a very stable voltage during TX.

Voltage on MIC is required to drive
an electret microphone.

LM741 is configured as a non-inverting 0..26 dB amplifier

Sheet: /Microphone Input/
File: microphone-input.sch
Id: 6/6 Title: R2AUK TRX MK2 ::: https://eax.me/ssb-transceiver/
