kholia/HF-Pre-Amp/v4/TIA_single.pdf

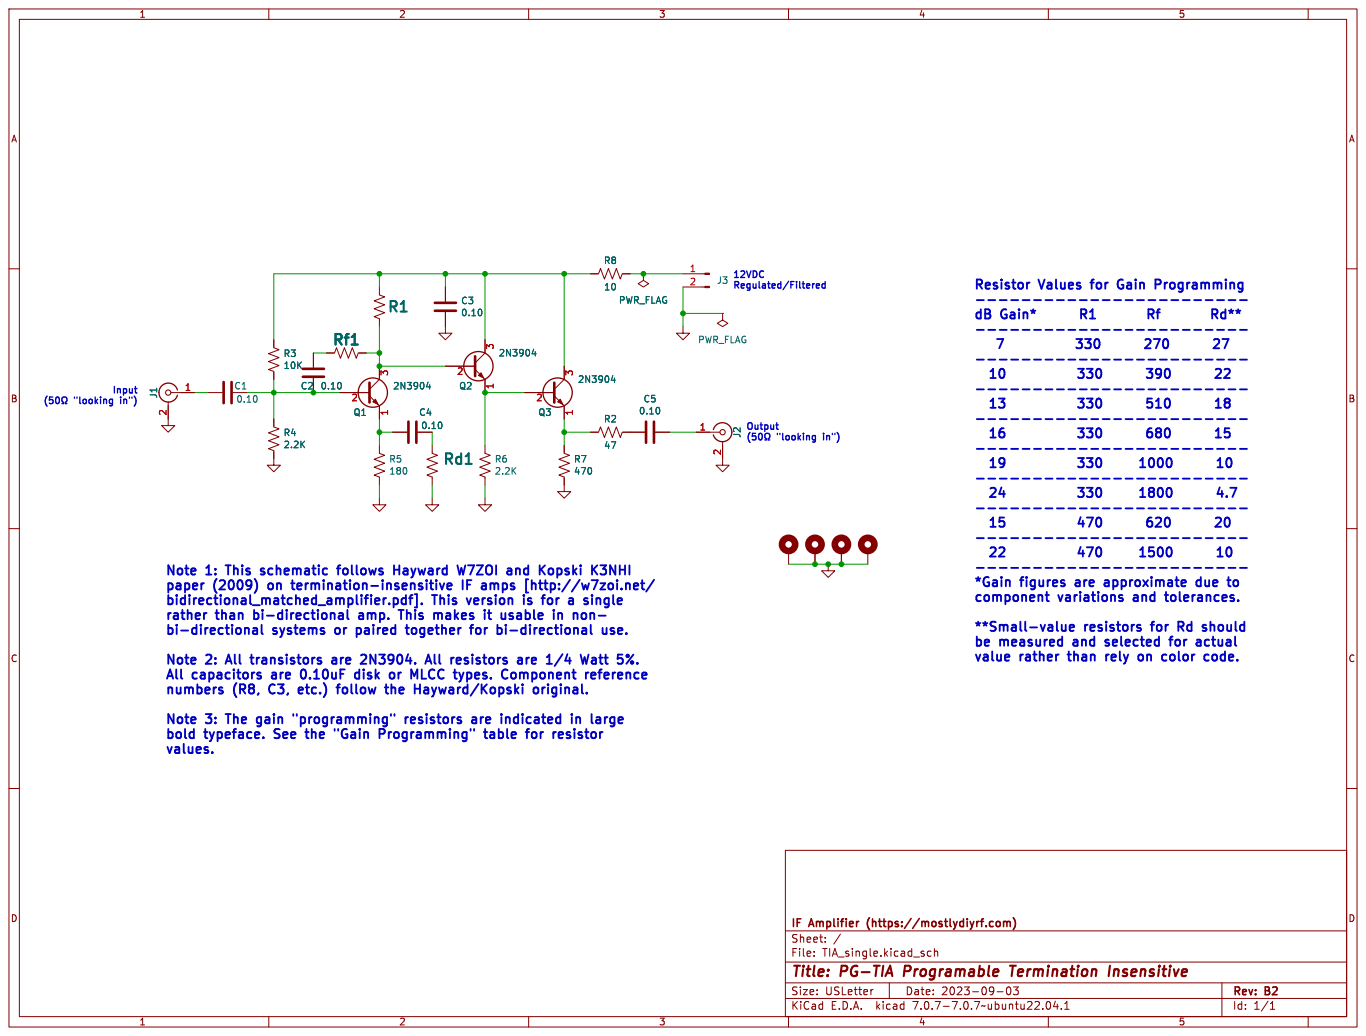
[picture p48: page 1]

Resistor Values for Gain Programming

component variations and tolerances.

be measured and selected for actual
value rather than rely on color code.
