kholia/HF-Pre-Amp/v2/HF-Pre-Amp.pdf

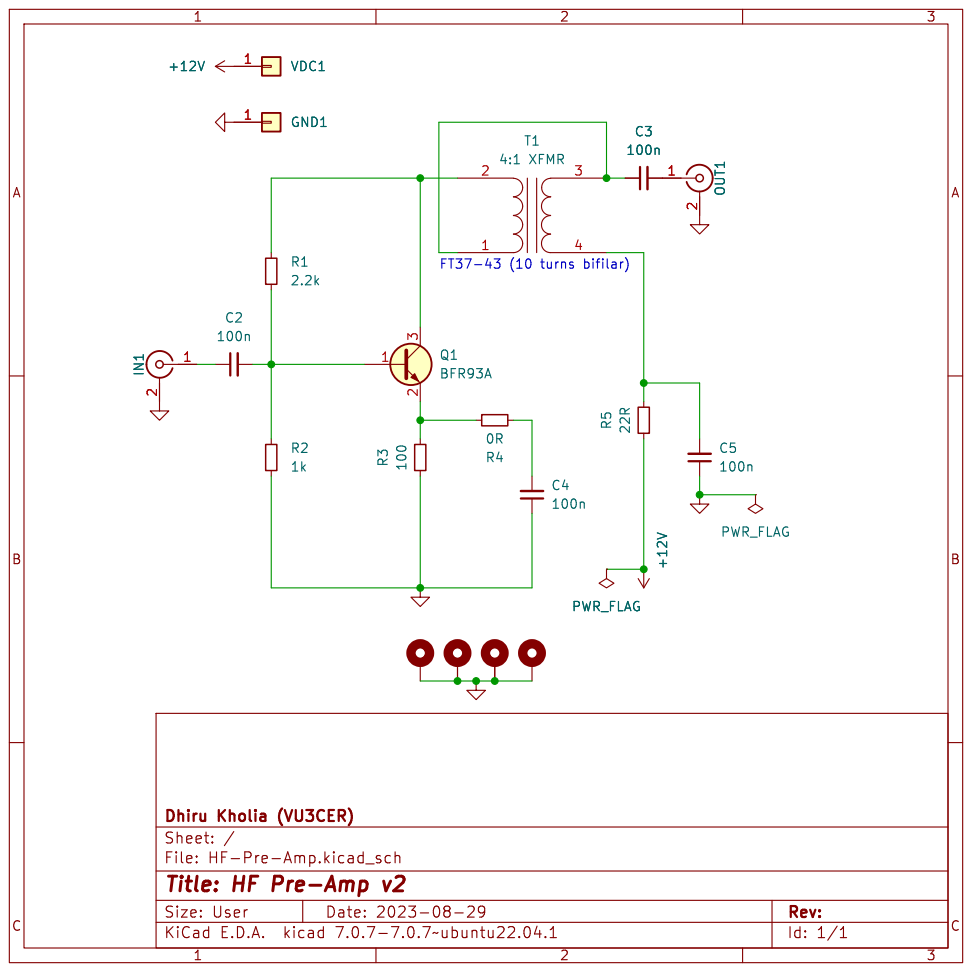
[picture p49: page 1]
