kholia/HF-Pre-Amp/v3/HF-Pre-Amp.pdf

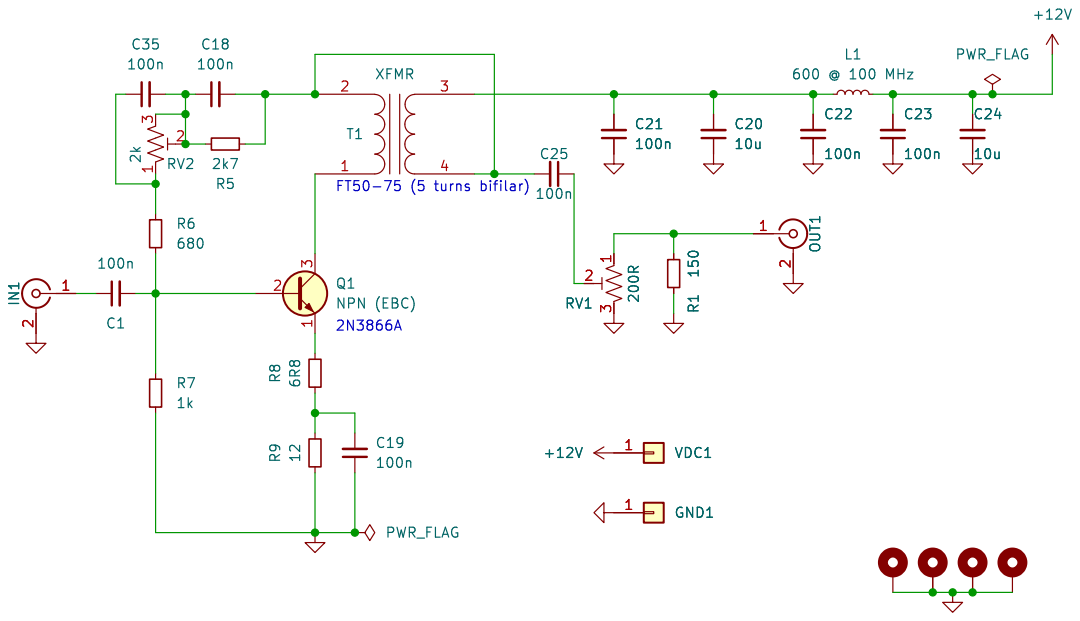
[picture p50: page 1]
