kholia/HF-Pre-Amp/v6/HF-Pre-Amp.pdf

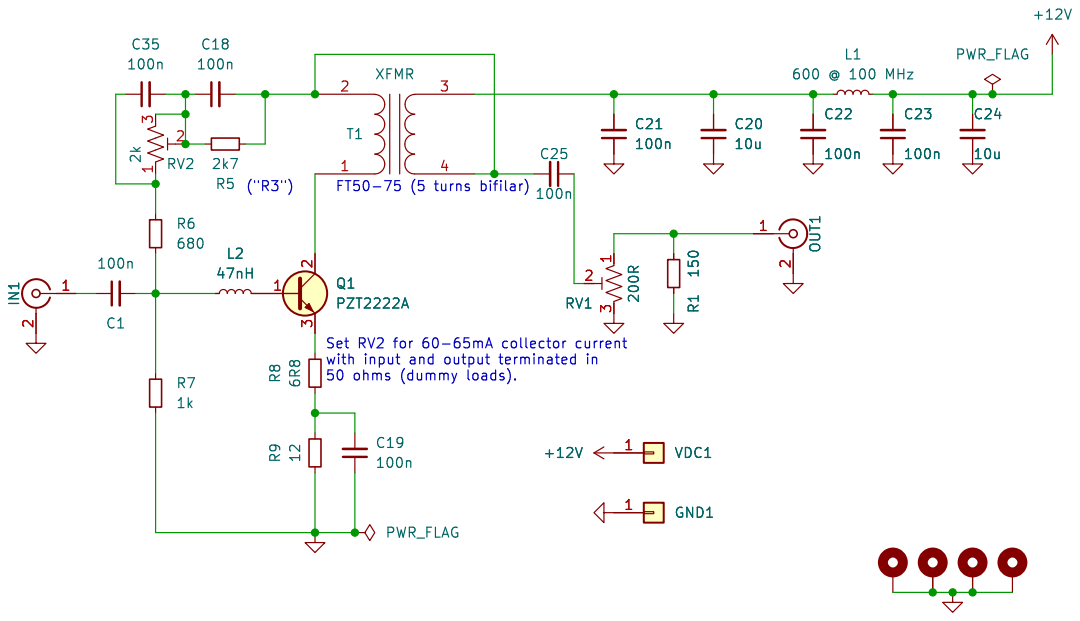
[picture p51: page 1]
