kholia/HF-Pre-Amp/v2/HF-Pre-Amp.kicad_pcb

## KiCad design v2/HF-Pre-Amp.kicad_pcb (2023-09-12, an earlier design)

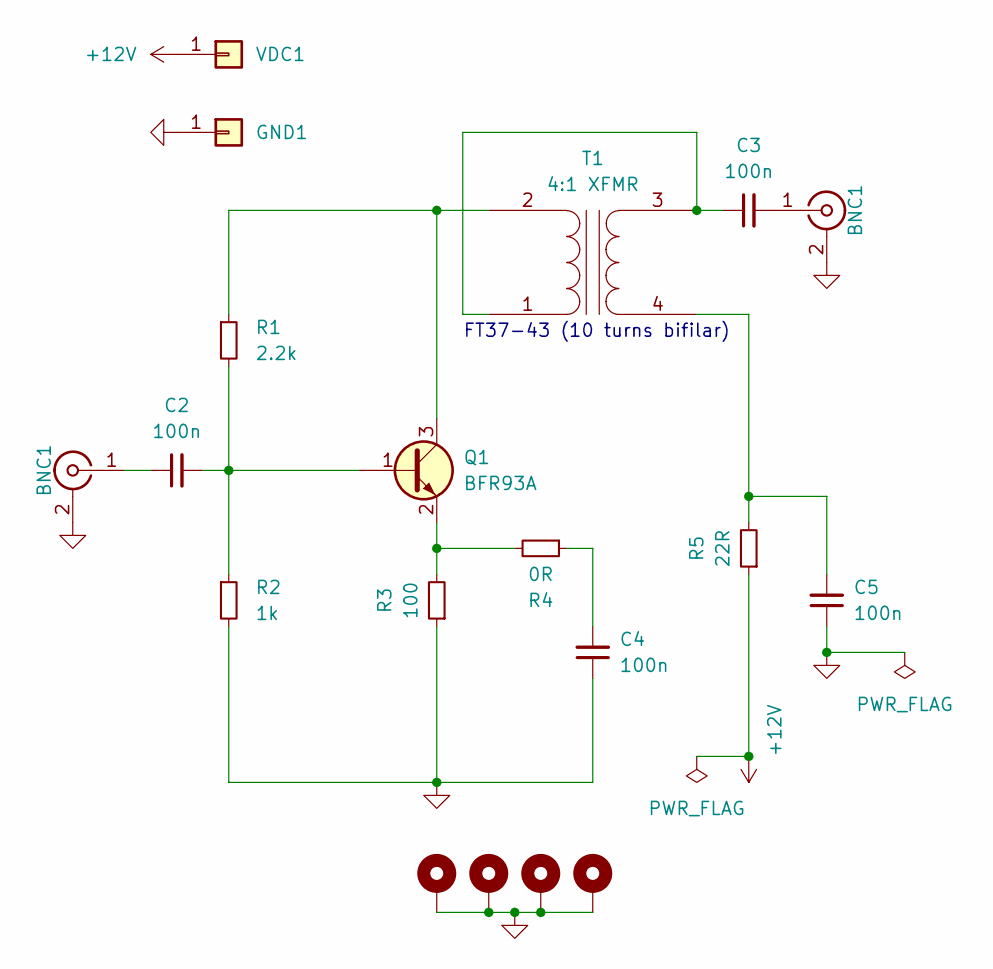
[picture p52: schematic HF-Pre-Amp.kicad_sch, HF Pre-Amp v2]

Parts:
BNC1: SMA; SMA_EDGELAUNCH_Modded
C2, C3, C4, C5: 100n; C_1206_3216Metric_Pad1.33x1.80mm_HandSolder
GND1: Conn_01x01; TestPoint_Pad_3.0x3.0mm
H1, H2, H3, H4: MountingHole_Pad; MountingHole_2.2mm_M2_Pad_Via
Q1: BFR93A; SOT-23_Handsoldering
R1: 2.2k; R_1206_3216Metric_Pad1.30x1.75mm_HandSolder
R2: 1k; R_1206_3216Metric_Pad1.30x1.75mm_HandSolder
R3: 100; R_1206_3216Metric_Pad1.30x1.75mm_HandSolder
R4: 0R; R_1206_3216Metric_Pad1.30x1.75mm_HandSolder
R5: 22R; R_1206_3216Metric_Pad1.30x1.75mm_HandSolder
T1: 4:1 XFMR; Transformer_Toroid_Horizontal_D10.5mm_Amidon-T37
VDC1: Conn_01x01; TestPoint_Pad_3.0x3.0mm

Connections:
+12V: R5.1, VDC1.1
GND: C4.1, C5.1, GND1.1, H1.1, H2.1, H3.1, H4.1, R2.2, R3.1; also elsewhere on the board
unnamed: C4.2, R4.1
unnamed 3: C2.1; also elsewhere on the board
unnamed 4: C3.2; also elsewhere on the board
unnamed: C2.2, Q1.1 (B), R1.2, R2.1
unnamed: Q1.3 (C), R1.1, T1.2 (AB)
unnamed: Q1.2 (E), R3.2, R4.2
unnamed: C3.1, T1.1 (AA), T1.3 (SA)
unnamed: C5.2, R5.2, T1.4 (SB)

Notes on the sheet:
FT37-43 (10 turns bifilar)

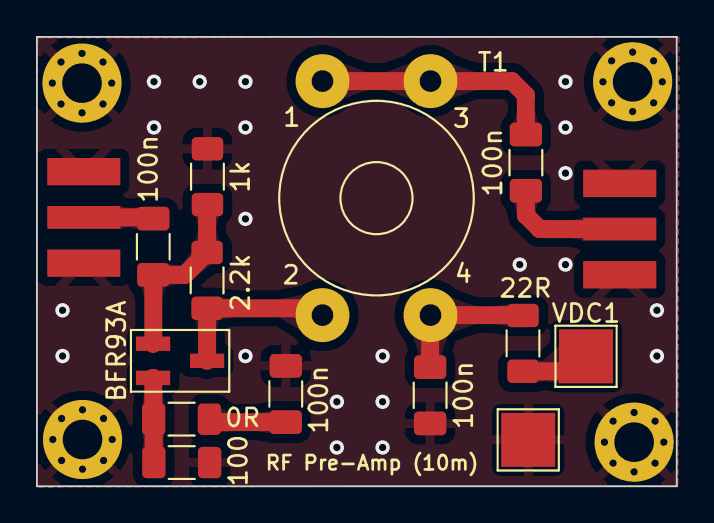
[picture p53: board v2/HF-Pre-Amp.kicad_pcb from above]

Board: 2 copper layers, 35.5 x 25.0 mm, 19 parts (0 on the bottom side), 10 nets.

Other parts of the board:
IN1: SMA; SMA_EDGELAUNCH_Modded
OUT1: SMA; SMA_EDGELAUNCH_Modded

Their connections:
GND: IN1.2 (Ext), OUT1.2 (Ext); also elsewhere on the board
unnamed 3: IN1.1 (In); also elsewhere on the board
unnamed 4: OUT1.1 (In); also elsewhere on the board
