kholia/HF-Pre-Amp/v1/HF-Pre-Amp.kicad_pcb

## KiCad design v1/HF-Pre-Amp.kicad_pcb (2023-09-12, an earlier design)

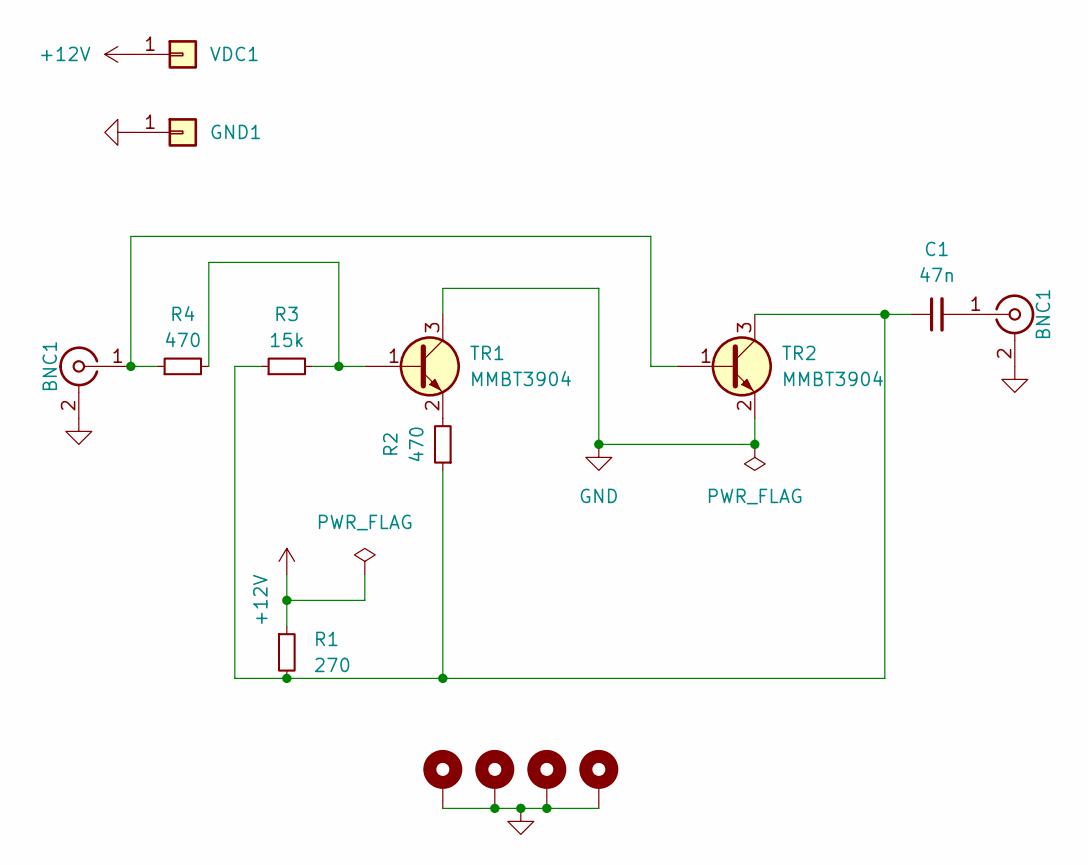
[picture p54: schematic HF-Pre-Amp.kicad_sch, Clean 28 MHz amplified RF source]

Parts:
BNC1: SMA; SMA_EDGELAUNCH_Modded
C1: 47n; C_1206_3216Metric_Pad1.33x1.80mm_HandSolder
GND1: Conn_01x01; TestPoint_Pad_2.5x2.5mm
H1, H2, H3, H4: MountingHole_Pad; MountingHole_2.2mm_M2_Pad_Via
R1: 270; R_1206_3216Metric_Pad1.30x1.75mm_HandSolder
R2, R4: 470; R_1206_3216Metric_Pad1.30x1.75mm_HandSolder
R3: 15k; R_1206_3216Metric_Pad1.30x1.75mm_HandSolder
TR1, TR2: MMBT3904; SOT-23_Handsoldering
VDC1: Conn_01x01; TestPoint_Pad_2.5x2.5mm

Connections:
+12V: R1.1, VDC1.1
GND: GND1.1, H1.1, H2.1, H3.1, H4.1, TR1.3 (C), TR2.2 (E); also elsewhere on the board
unnamed 2: R4.1, TR2.1 (B); also elsewhere on the board
unnamed 3: C1.2; also elsewhere on the board
unnamed: R3.2, R4.2, TR1.1 (B)
unnamed: R2.2, TR1.2 (E)
unnamed: C1.1, R1.2, R2.1, R3.1, TR2.3 (C)

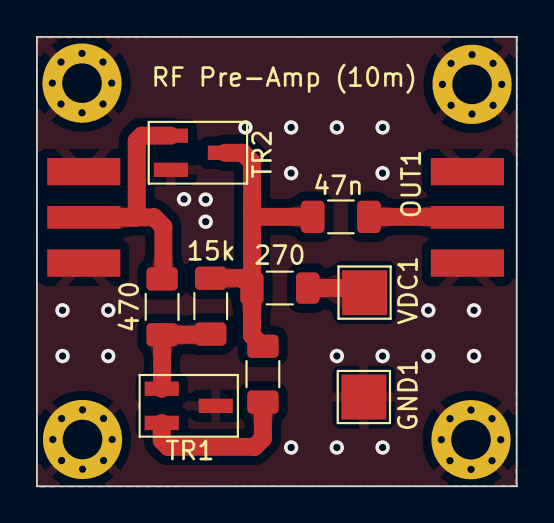
[picture p55: board v1/HF-Pre-Amp.kicad_pcb from above]

Board: 2 copper layers, 26.7 x 25.0 mm, 15 parts (0 on the bottom side), 7 nets.

Other parts of the board:
IN1: SMA; SMA_EDGELAUNCH_Modded
OUT1: SMA; SMA_EDGELAUNCH_Modded

Their connections:
GND: IN1.2 (Ext), OUT1.2 (Ext); also elsewhere on the board
unnamed 2: IN1.1 (In); also elsewhere on the board
unnamed 3: OUT1.1 (In); also elsewhere on the board
