kholia/HF-Pre-Amp/v6/HF-Pre-Amp.kicad_pcb

## KiCad design v6/HF-Pre-Amp.kicad_pcb (2023-09-12, an earlier design)

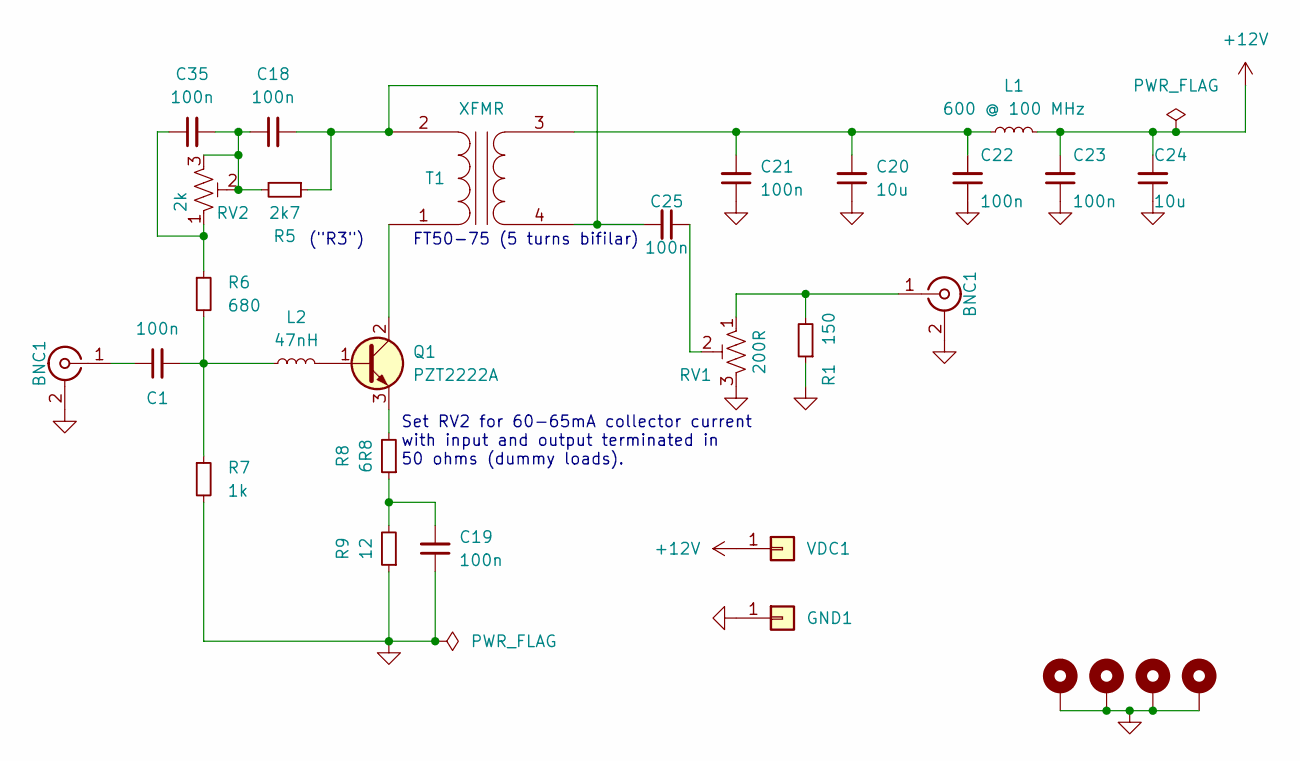
[picture p56: schematic HF-Pre-Amp.kicad_sch, HF Pre-Amp v3.02]

Parts:
BNC1: SMA; SMA_EDGELAUNCH_Modded
C1, C18, C19, C21, C22, C23, C25, C35: 100n; C_1206_3216Metric_Pad1.33x1.80mm_HandSolder
C20, C24: 10u; C_1206_3216Metric_Pad1.33x1.80mm_HandSolder
GND1: Conn_01x01; TestPoint_Pad_3.0x3.0mm
H1, H2, H3, H4: MountingHole_Pad; MountingHole_2.2mm_M2_Pad_Via
L1: 600 @ 100 MHz; L_1206_3216Metric_Pad1.42x1.75mm_HandSolder
L2: 47nH; L_1008_2520Metric_Pad1.43x2.20mm_HandSolder
Q1: PZT2222A; SOT-223-3_TabPin2
R1: 150; R_1206_3216Metric_Pad1.30x1.75mm_HandSolder
R5: 2k7; R_1206_3216Metric_Pad1.30x1.75mm_HandSolder
R6: 680; R_1206_3216Metric_Pad1.30x1.75mm_HandSolder
R7: 1k; R_1206_3216Metric_Pad1.30x1.75mm_HandSolder
R8: 6R8; R_1206_3216Metric_Pad1.30x1.75mm_HandSolder
R9: 12; R_1206_3216Metric_Pad1.30x1.75mm_HandSolder
RV1: 200R; Potentiometer_Bourns_3386P_Vertical
RV2: 2k; Potentiometer_Bourns_3386P_Vertical
T1: XFMR; FT50-43 Transformer
VDC1: Conn_01x01; TestPoint_Pad_3.0x3.0mm

Connections:
+12V: C23.2, C24.2, L1.2, VDC1.1
GND: C19.1, C20.1, C21.1, C22.1, C23.1, C24.1, GND1.1, H1.1, H2.1, H3.1, H4.1, R1.1, R7.2, R9.1, RV1.3; also elsewhere on the board
unnamed: C1.2, L2.1, R6.2, R7.1
unnamed: C18.1, C35.2, R5.2, RV2.2, RV2.3
unnamed: C19.2, R8.1, R9.2
unnamed: C25.1, RV1.2
unnamed: C35.1, R6.1, RV2.1
unnamed 7: C1.1; also elsewhere on the board
unnamed 8: R1.2, RV1.1; also elsewhere on the board
unnamed: L2.2, Q1.1 (B)
unnamed: Q1.2 (C), T1.1 (AA)
unnamed: Q1.3 (E), R8.2
unnamed: C18.2, C25.2, R5.1, T1.2 (AB), T1.4 (SB)
unnamed: C20.2, C21.2, C22.2, L1.1, T1.3 (SA)

Notes on the sheet:
("R3")
FT50-75 (5 turns bifilar)
Set RV2 for 60-65mA collector current with input and output terminated in 50 ohms (dummy loads).

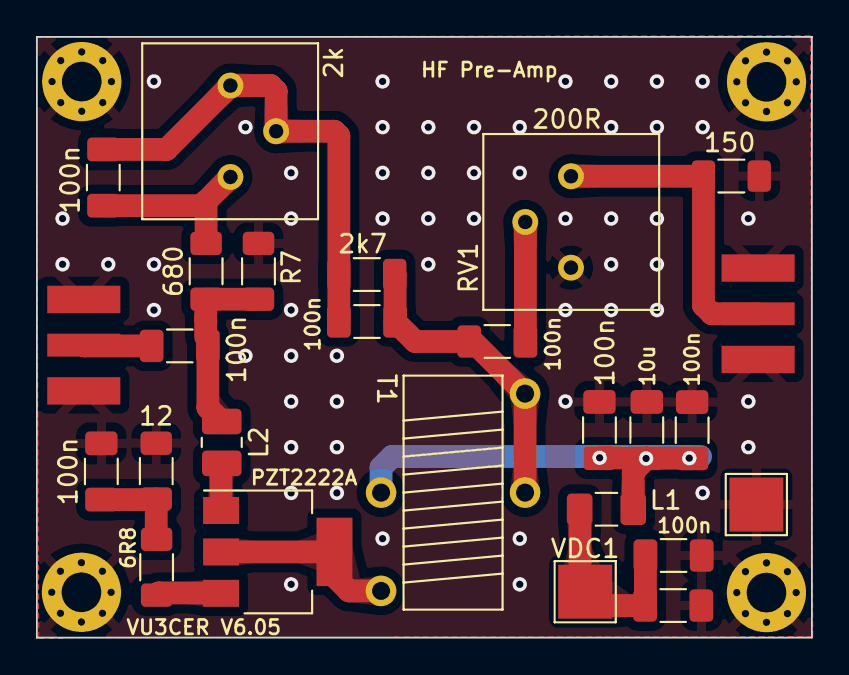
[picture p57: board v6/HF-Pre-Amp.kicad_pcb from above]

Board: 2 copper layers, 43.1 x 33.4 mm, 30 parts (0 on the bottom side), 14 nets.

Other parts of the board:
IN1: SMA; SMA_EDGELAUNCH_Modded
OUT1: SMA; SMA_EDGELAUNCH_Modded

Their connections:
GND: IN1.2 (Ext), OUT1.2 (Ext); also elsewhere on the board
unnamed 7: IN1.1 (In); also elsewhere on the board
unnamed 8: OUT1.1 (In); also elsewhere on the board
