kholia/HF-Pre-Amp/v5/TIA_single.kicad_pcb

## KiCad design v5/TIA_single.kicad_pcb (2023-09-12, an earlier design)

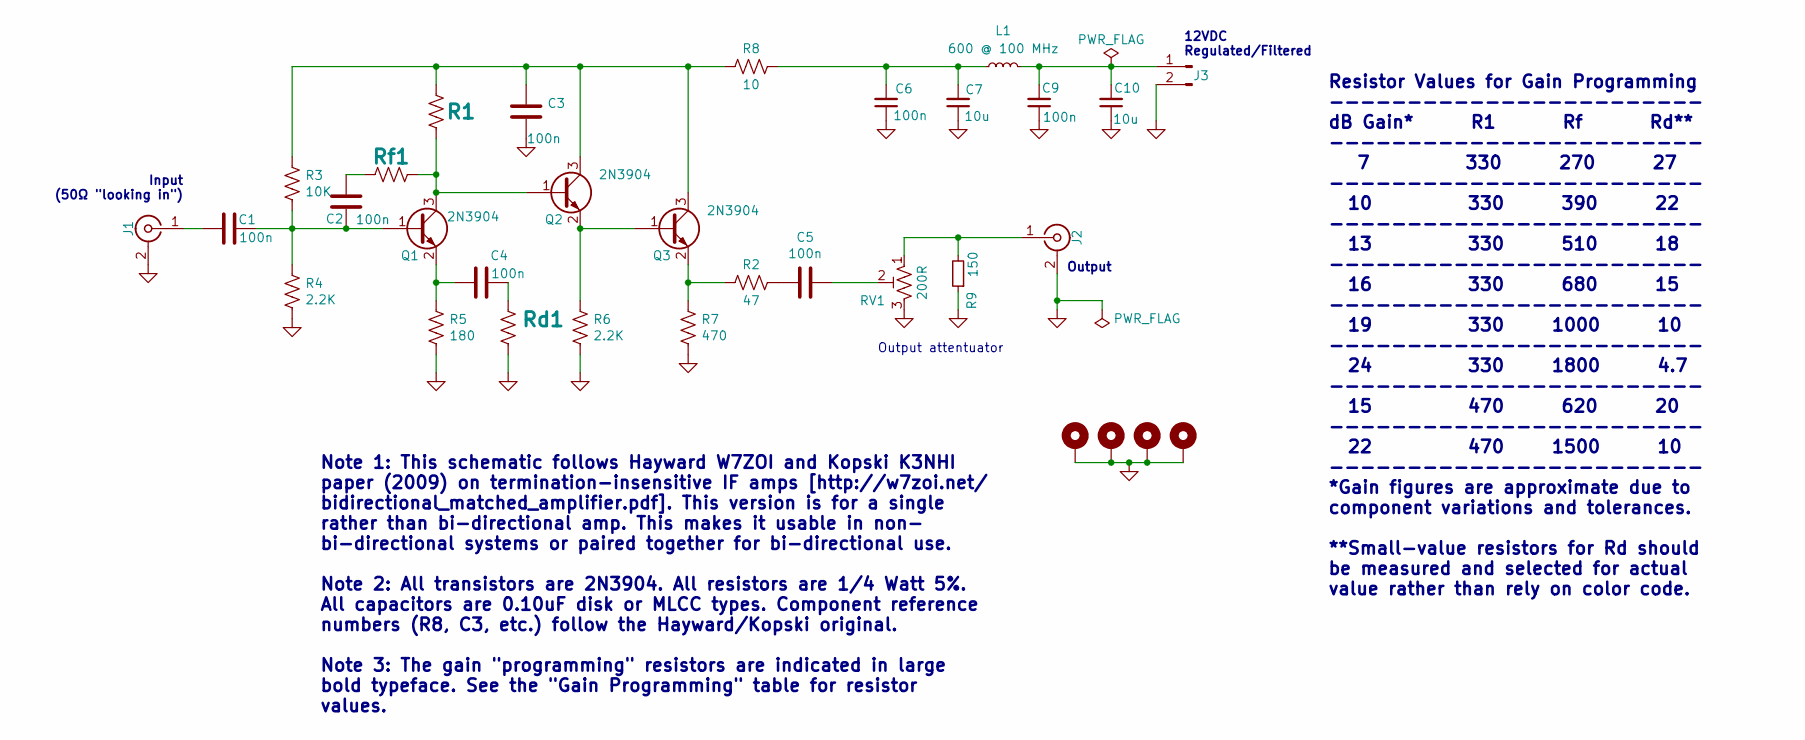
[picture p58: schematic TIA_single.kicad_sch, PG-TIA Programable Termination Insensitive]

Parts:
C1, C2, C3, C4, C5, C6, C9: 100n; C_1206_3216Metric_Pad1.33x1.80mm_HandSolder
C7, C10: 10u; C_1206_3216Metric_Pad1.33x1.80mm_HandSolder
H1, H2, H3, H4: MountingHole_Pad; MountingHole_2.2mm_M2_Pad_Via
J1: Conn_Coaxial; SMA_EDGELAUNCH_Modded
J2: SMA; SMA_EDGELAUNCH_Modded
J3: Conn_01x02_Male; PinHeader_1x02_P2.54mm_Vertical
L1: 600 @ 100 MHz; L_1206_3216Metric_Pad1.42x1.75mm_HandSolder
Q1, Q2, Q3: 2N3904; SOT-23_Handsoldering
R1: 330; R_1206_3216Metric_Pad1.30x1.75mm_HandSolder
R2: 47; R_1206_3216Metric_Pad1.30x1.75mm_HandSolder
R3: 10K; R_1206_3216Metric_Pad1.30x1.75mm_HandSolder
R4, R6: 2.2K; R_1206_3216Metric_Pad1.30x1.75mm_HandSolder
R5: 180; R_0805_2012Metric_Pad1.20x1.40mm_HandSolder
R7: 470; R_1206_3216Metric_Pad1.30x1.75mm_HandSolder
R8: 10; R_1206_3216Metric_Pad1.30x1.75mm_HandSolder
R9: 150; R_1206_3216Metric_Pad1.30x1.75mm_HandSolder
RV1: 200R; Potentiometer_Bourns_3296W_Vertical
Rd1: 15; R_1206_3216Metric_Pad1.30x1.75mm_HandSolder
Rf1: 680; R_1206_3216Metric_Pad1.30x1.75mm_HandSolder

Connections:
GND: C3.1, C6.1, C7.1, C9.1, C10.1, H1.1, H2.1, H3.1, H4.1, J1.2 (Ext), J2.2 (Ext), J3.2, R4.2, R5.2, R6.2, R7.2, R9.1, RV1.3, Rd1.2
unnamed: C2.2, Rf1.2
unnamed: C4.1, Rd1.1
unnamed: C5.1, RV1.2
unnamed: C5.2, R2.1
unnamed: C6.2, C7.2, L1.1, R8.1
unnamed: C1.2, J1.1 (In)
unnamed: J2.1 (In), R9.2, RV1.1
unnamed: C9.2, C10.2, J3.1, L1.2
unnamed: C1.1, C2.1, Q1.1 (B), R3.2, R4.1
unnamed: Q1.3 (C), Q2.1 (B), R1.2, Rf1.1
unnamed: C4.2, Q1.2 (E), R5.1
unnamed: C3.2, Q2.3 (C), Q3.3 (C), R1.1, R3.1, R8.2
unnamed: Q2.2 (E), Q3.1 (B), R6.1
unnamed: Q3.2 (E), R2.2, R7.1

Notes on the sheet:
Output attentuator
Note 1: This schematic follows Hayward W7ZOI and Kopski K3NHI paper (2009) on termination-insensitive IF amps [http://w7zoi.net/ bidirectional_matched_amplifier.pdf]. This version is for a single rather than bi-directional amp. This makes it usable in non- bi-directional systems or paired together 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
Output
Resistor Values for Gain Programming ------------------------ dB Gain* R1 Rf Rd** ------------------------ 7 330 270 27 ------------------------ 10 330 390 22 ------------------------ 13 330 510 18 ------------------------ 16 330 680 15 ------------------------ 19 330 1000 10 ----------------------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
Input (50Ω "looking in")
12VDC Regulated/Filtered

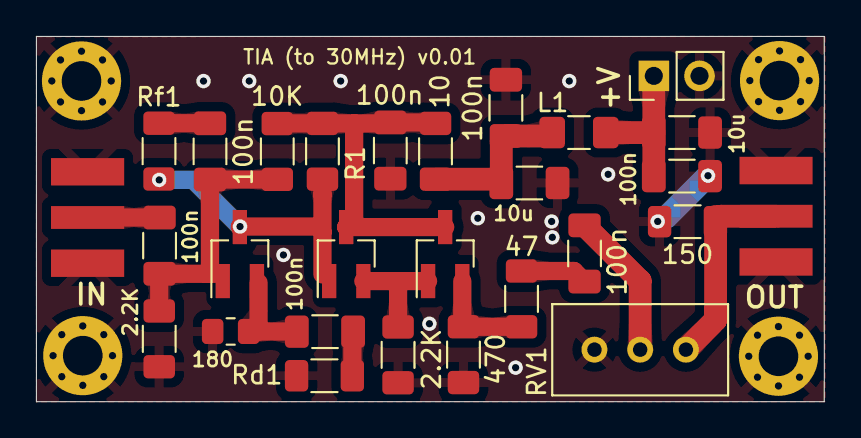
[picture p59: board v5/TIA_single.kicad_pcb from above]

Board: 2 copper layers, 43.8 x 20.3 mm, 32 parts (0 on the bottom side), 15 nets.
