kholia/HF-Pre-Amp/v4/TIA_single.kicad_pcb

## KiCad design v4/TIA_single.kicad_pcb (2023-09-12, an earlier design)

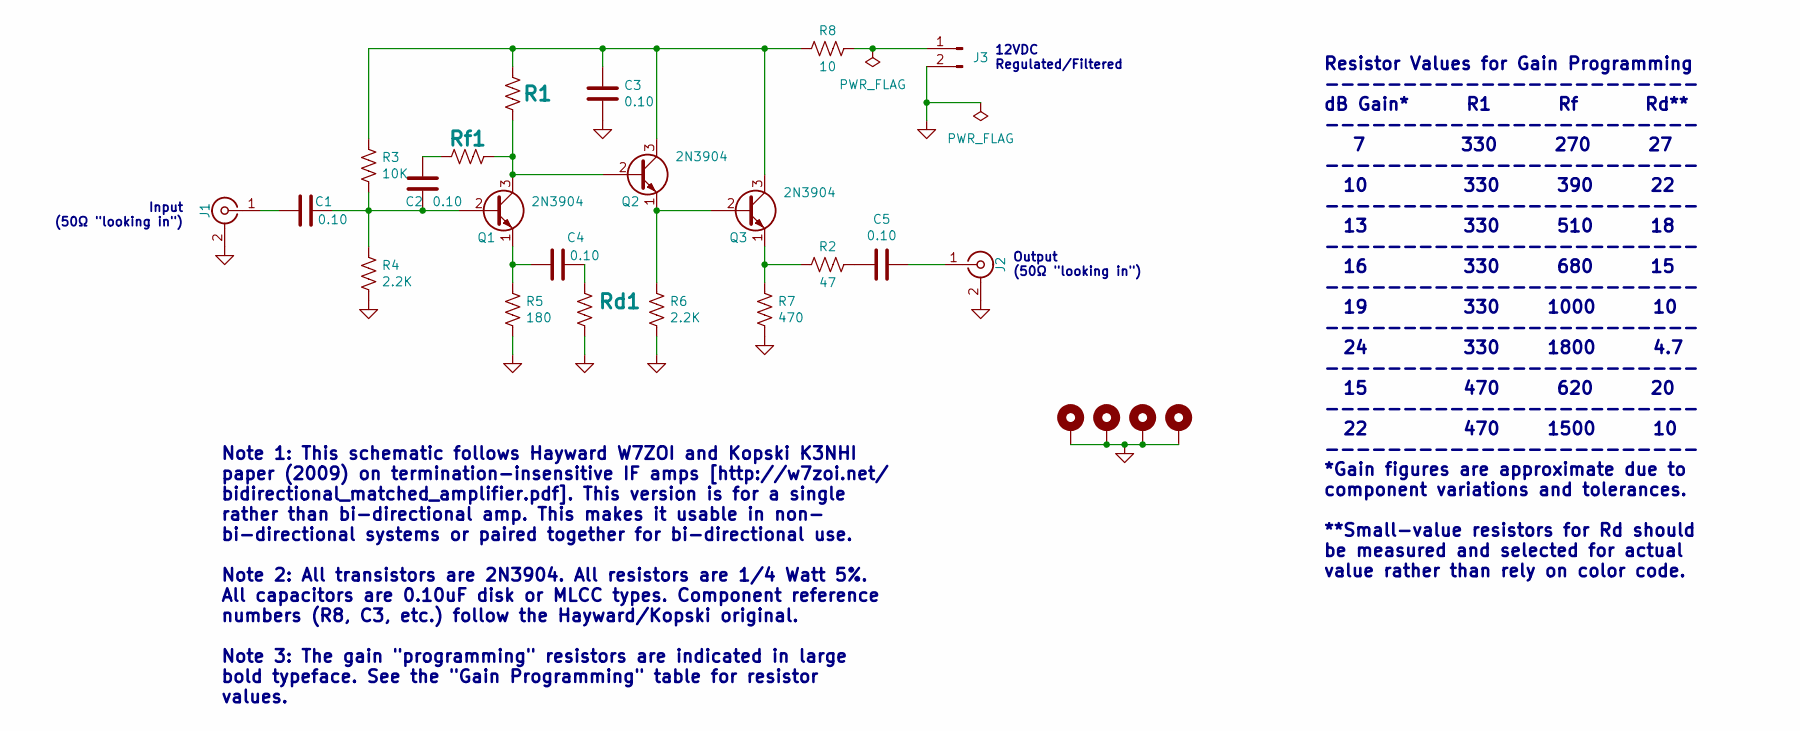
[picture p60: schematic TIA_single.kicad_sch, PG-TIA Programable Termination Insensitive]

Parts:
C1, C2, C3, C4, C5: 0.10; C_Disc_D3.0mm_W1.6mm_P2.50mm
H1, H2, H3, H4: MountingHole_Pad; MountingHole_2.2mm_M2_Pad_Via
J1: Conn_Coaxial; SMA_EDGELAUNCH_Modded
J2: SMA; SMA_EDGELAUNCH_Modded
J3: Conn_01x02_Male; PinHeader_1x02_P2.54mm_Vertical
Q1, Q2, Q3: 2N3904; TO-92_HandSolder
R1: 330; R_Axial_DIN0204_L3.6mm_D1.6mm_P2.54mm_Vertical
R2: 47; R_Axial_DIN0204_L3.6mm_D1.6mm_P2.54mm_Vertical
R3: 10K; R_Axial_DIN0204_L3.6mm_D1.6mm_P2.54mm_Vertical
R4, R6: 2.2K; R_Axial_DIN0204_L3.6mm_D1.6mm_P2.54mm_Vertical
R5: 180; R_Axial_DIN0204_L3.6mm_D1.6mm_P2.54mm_Vertical
R7: 470; R_Axial_DIN0204_L3.6mm_D1.6mm_P2.54mm_Vertical
R8: 10; R_Axial_DIN0204_L3.6mm_D1.6mm_P2.54mm_Vertical
Rd1: 15; R_Axial_DIN0204_L3.6mm_D1.6mm_P2.54mm_Vertical
Rf1: 680; R_Axial_DIN0204_L3.6mm_D1.6mm_P2.54mm_Vertical

Connections:
GND: C3.1, H1.1, H2.1, H3.1, H4.1, J1.2 (Ext), J2.2 (Ext), J3.2, R4.2, R5.2, R6.2, R7.2, Rd1.2
unnamed: C2.2, Rf1.2
unnamed: C4.1, Rd1.1
unnamed: C5.2, R2.1
unnamed: C1.2, J1.1 (In)
unnamed: C5.1, J2.1 (In)
unnamed: J3.1, R8.1
unnamed: C1.1, C2.1, Q1.2 (B), R3.2, R4.1
unnamed: Q1.3 (C), Q2.2 (B), R1.2, Rf1.1
unnamed: C4.2, Q1.1 (E), R5.1
unnamed: C3.2, Q2.3 (C), Q3.3 (C), R1.1, R3.1, R8.2
unnamed: Q2.1 (E), Q3.2 (B), R6.1
unnamed: Q3.1 (E), R2.2, R7.1

Notes on the sheet:
Note 1: This schematic follows Hayward W7ZOI and Kopski K3NHI paper (2009) on termination-insensitive IF amps [http://w7zoi.net/ bidirectional_matched_amplifier.pdf]. This version is for a single rather than bi-directional amp. This makes it usable in non- bi-directional systems or paired together 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
Output (50Ω "looking in")
Resistor Values for Gain Programming ------------------------ dB Gain* R1 Rf Rd** ------------------------ 7 330 270 27 ------------------------ 10 330 390 22 ------------------------ 13 330 510 18 ------------------------ 16 330 680 15 ------------------------ 19 330 1000 10 ----------------------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
Input (50Ω "looking in")
12VDC Regulated/Filtered

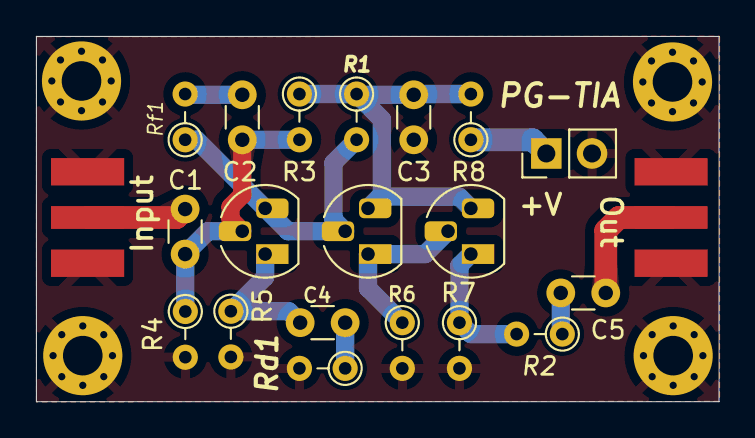
[picture p61: board v4/TIA_single.kicad_pcb from above]

Board: 2 copper layers, 37.9 x 20.3 mm, 25 parts (0 on the bottom side), 13 nets.
